jsoeterbroek/ktemata/docs/PAINT.md

# r5 paint schemes — deck and lid cover

**Strata is the chosen scheme.** It is the design to build; Meridian and Bearing are kept as record
of the alternatives and because the generator still produces them.

Three airbrush designs for the two printed surfaces you actually look at: the **deck** (keyboard
side, seen when the case is open) and the **lid cover** (one flat front panel around the recessed
Touch Display 2, 5", seen when it is closed). Each scheme is one continuous design across
both parts, not two decorations that happen to share a palette.

```
python3 cad/tools/paint.py                          # all three sheets + contact sheet
python3 cad/tools/paint.py --scheme 2 --stencils    # Strata + its cut files (also the default)
python3 cad/tools/paint.py --scheme 1               # Meridian colour sheet
python3 cad/tools/paint.py --stickers                # the two type blocks as sticker PDFs
python3 cad/tools/paint.py --no-png                 # SVGs only
```

Output lands in `docs/paint/`:

| File | What it is |
|---|---|
| `ktemata_paint_1_meridian.svg` / `.png` | **MERIDIAN** — a chart graticule ruled from the hinge |
| `ktemata_paint_2_strata.svg` / `.png` | **STRATA** — five bands up both rails, straight past the seam |
| `ktemata_paint_3_bearing.svg` / `.png` | **BEARING** — a slate border and one amber trace through the seam |
| `ktemata_paint_all.png` | the three sheets side by side, for choosing |
| `ktemata_stencil_{deck,cover}_{deep_amber,slate,amber,ash,hairline,ink}.svg` | **Strata cut files**, one per colour pass, `--stencils` |
| `ktemata_sticker_deck_wordmark_91x22.4mm_bleed.pdf` | **the deck wordmark sticker**, artwork only, `--stickers` |
| `ktemata_sticker_cover_motto_<W>x<H>mm_bleed.pdf` | **the lid motto sticker**, artwork only, `--stickers`; filename records its fitted trim size |

The SVGs are **1:1 in millimetres** and are drawn from the model, so they print as masking
templates: 400 gsm card or vinyl, cut to the panels, laid on the part. There is a 50 mm scale bar
on each sheet to check the printer did not rescale.

## The rule the three schemes share

The case opens flat into one face: the cover's 233.5 × 178.1 panel, and the deck's 243.3 × 186.8
plate, which is larger because it fills the host's cavity at its own height (see R5.md, "Your
host's actual interior"). Both are measured **from the hinge** (`y = 0`), exactly as `common.scad`
does, and they share **one x axis**. So a mark at `x = 214` is 19.5 mm from the right edge on the
cover *and* on the deck, and a mark at `y = 40` is 40 mm from the seam on whichever half you are
looking at. The deck's plate starts 4.4 mm before the seam and ends 4.4 mm past the cassette's
latch edge; that overhang is painted as part of the deck face.

Everything continuous in these designs is keyed to that datum:

- **MERIDIAN** lays its graticule out from the hinge at `L/10 = 17.81 mm` pitch, so line *n* is
  the same distance from the seam on either half.
- **STRATA** keys its bands to **x**, not y: each rail runs dead straight from the cover into the
  deck, and the U closes across the hinge.
- **BEARING** runs one 3 mm trace on `x = 215.5` down both parts, meeting in a gateway square
  straddling the seam.

## What the hardware allows — measured, not guessed

These are the constraints the artwork obeys, and `cad/tools/paint_probe.scad` feeds them to the
generator straight from `common.scad`. Change a part and the sheets follow; the assertions fail
rather than drawing a line through a fan.

- **The cover has one flat front at `z = 18.92 mm`.** Its rear mounting skin is **4.00 mm** thick
  (`z = 0..4.00`), and the display recess is **14.92 mm** deep (`z = 4.00..18.92`). The display
  glass and the entire broad cover front are coplanar; there is no raised bezel. The **145.4 ×
  93.46 mm display opening** (`R5_PANEL` + 1.0 mm clearance per side) is centred at
  `x 44.05..189.45`, `y 42.32..135.78`. Meridian's **7 mm slate border** around that opening is
  flat paint and a layout datum, not a keep-out. Marks may cross it; only the display opening,
  cable notch and reserved type interrupt them. The default layout leaves **37.05 mm
  outside the painted border in x** and a **35.32 mm latch band** below it, all on that same face.
  Nothing else on the cover breaks the painted face: the 7" build's FFC fold pocket is blind and
  lives in `cad/r5_lid_cover_waveshare_7in.scad`, and the 5" cover has no pocket at all.
- **The deck's free fields** are the **40.95 mm side rails**, the **35.6 mm strip** between the OLED
  window (ends `y 66.9`) and the keyboard pocket (starts `y 102.5`), and the **16 mm** between the
  keyboard pocket (ends `y 162.1`) and the latch edge. The right rail carries the power button
  (`213.0, 160.1`) and the charge socket (`216.0, 90.0`).
- **BEARING's retained trace uses the right-side lane at x 216.5 .. 223.0**. The **charge socket**
  (Ø14 envelope at 216.0, 90.0) interrupts that trace; if the alternative layout were revived it
  would need to jog around the socket, x 209..223. Removing the FB2 opening also leaves the left
  rail available for a future alternative layout.

  The power button is why the deck now has a hole where the 5" layout had clean rail: it moved
  off the lid when the panel grew to 7", and the rail at x 213 is the only place on the deck that
  is both clear of the keyboard pocket and clear of every board underneath. Its Ø19 nut needs
  9.2 mm of clearance to the keyboard skirt, which is exactly what the rail gives.
- **The lettering blocks are part of the mask.** MERIDIAN's graticule stops at the wordmark and
  the motto rather than running under them — the blocks are declared in `Model.type_boxes`,
  derived from the sticker trim, so no scheme can paint through them by accident and the
  graticule never ends as a sliver under the vinyl's edge.

## Paint order and finish

All three use the same process; only the masks change.

1. Scuff 400, clean, adhesion promoter for PETG, then **graphite base** (`#151b21`, the site's
   `--bg`) over the whole face.
2. Lay the masks for the first colour, spray, let it flash off. Thin coats — airbrush paint builds
   up in an aperture and reads as a burr.
3. Repeat per colour. The order on each sheet is the order to spray; darkest to lightest, so a
   light slip can be covered and a dark one cannot.
4. **Matte 2K clear** over everything.
5. Lettering last: MERIDIAN's two type blocks are **printed stickers** laid on the cleared plate
   (see below); STRATA and BEARING keep the stencil pass, un-cleared, so it keeps its edge.

### Palette

Taken from `site/style.css` so the case and the site are the same object:

| Name | Hex | Role | Pantone (Solid Coated) | Vallejo Model Air |
|---|---|---|---|---|
| graphite | `#151b21` | `--bg` — base coat, all three | Black 6 C `#101820` ΔE 1.7 | 71.057 Black ΔE 7.1 |
| amber | `#c99a63` | `--accent` — the line work that crosses the seam | 7509 C `#d6a461` ΔE 3.9 | 71.348 USAF Tan ΔE 2.9 |
| deep amber | `#8a6234` | `--accent-soft` — the seam rule, shading | 7575 C `#835d32` ΔE 2.2 | 71.032 Golden Brown ΔE 4.0 |
| slate | `#26313a` | `--panel`, lifted one step so it reads next to graphite at 300 mm | 7546 C `#253746` ΔE 3.5 | 3 : 1 71.057 Black + 71.087 Steel Blue ΔE 2.4 |
| ash | `#7c8993` | secondary line work | 430 C `#7c878e` ΔE 1.6 | 71.307 BS Medium Sea Grey ΔE 3.5 |
| light grey | `--muted` `#a9b2bb` | short graticule ticks, chart dots | 429 C `#a2aaad` ΔE 3.8 | 71.345 Russian AF Grey N.8 ΔE 4.4 |
| light amber | `#e2bd8d` | long ticks, the deck wordmark | 7508 C `#e1b87f` ΔE 2.4 | 71.074 Radome Tan ΔE 3.6 |
| ivory | `--fg` `#f2ebe0` | the motto | 7527 C `#d6d2c4` ΔE 6.3 | 71.279 Insignia White ΔE 3.9 |

Every sheet's `PALETTE` strip carries the five colours that scheme actually uses.

**How to read the two mixed columns.** ΔE is CIEDE2000 between the site hex and the matched
swatch, computed in CIELAB from the sRGB values; **below ~2 is indistinguishable side by side,
below ~5 reads the same at arm's length in daylight**, and everything in the table is under 5
except graphite and ivory. Those two are at the ends of the range where neither system has a
chip: nothing in Model Air is as dark as `#151b21` (71.057 is a half-step lighter, which the matte
clear mostly hides), and every Pantone chip near `#f2ebe0` is yellower — 7527 C is the closest
neutral and Pantone has no true off-white. Slate needs the two-pot mix because no single matte
Model Air matches it; 71.300 Glossy Sea Blue is closer but gloss, which is wrong under the 2K
clear on the painted border.

The Pantone column is for **checking, not spraying** — Pantone sells no paint. Use the chip at the
hobby shop to judge a tint under daylight, or to order the same tone from a paint mixer. The
Vallejo column is the **Model Air** number (the airbrush range, 71.xxx) because every pass here is
sprayed; Model Color (70.xxx) has hand-brush equivalents that are close but not identical, and
Model Color is brush-ready, so it will not go through a 0.2 mm nozzle without thinning and has no
place in these masks. Vallejo publishes no official RGB values — the hexes behind the ΔE numbers
come from community colour databases, so treat ΔE as a comparison between two approximations of
each colour, not as a measurement of the bottle in your hand.

## Cutting the masks

`--stencils` writes the six selected Strata cut files for each part, derived from the same mark
data as the colour sheet:

| Filename suffix | Pass | Cut |
|---|---|---|
| `deep_amber` | deep amber | 8 mm outer rails and the 2.6 mm latch band at `y 2.6` |
| `slate` | slate | 5 mm rail bands |
| `amber` | amber | 12 mm rail bands |
| `ash` | ash | 3 mm rail bands |
| `hairline` | light amber | 0.6 mm rail hairlines at `x 8` and `x W-8` |
| `ink` | graphite shadow | 0.6 mm latch shadow at `y 5.2` |

The innermost 4 mm rail band is the existing graphite base and needs no mask. Files are named
`ktemata_stencil_{deck,cover}_<pass>.svg`. The same masks are also printable as rigid 1.2 mm panels
(`stl/stencil/stencil_*.stl`) — see **Printed masks** below. Sheets and STLs come from `strata_marks()`,
so they cannot disagree.

Black is the sheet you lay on the part; white is what the blade removes. The full-length rail cuts
and the full-width latch cut can separate a mask into strips. Kiss-cut the vinyl, leave the backing
on, and use transfer tape to lift every island onto the part in register. The **0.6 mm hairline and
latch-shadow passes are at the limit for a hand-cut blade**; a vinyl cutter or 0.6 mm pinstripe tape
is preferable. Registration crosses in the margins align the passes; the part outline is the datum.

The six generated masks cover the rectangular colour geometry only. The wordmark and motto remain
a separate hand-cut type step from the colour sheet; they are not included in these files.

## Printed masks

```bash
python3 cad/tools/stencil_stl.py                  # twelve Strata masks, 1.2 mm thick
python3 cad/tools/stencil_stl.py --part cover      # six cover masks
python3 cad/tools/stencil_stl.py --pass amber      # one pass on both parts
python3 cad/tools/stencil_stl.py --thickness 2.0   # stiffer
```

Writes `stl/stencil/stencil_{deck,cover}_{deep_amber,slate,amber,ash,hairline,ink}.stl`: the part outline
with that pass's slots cut straight through and no handling margin — 243.3 × 186.8 mm for the deck,
233.5 × 178.1 mm for the cover. The deck fits a 256 mm bed. Full-length cuts make some masks
multi-piece; arrange those pieces against the part outline, or use the registered SVG sheet with
transfer tape when a single handling assembly is preferable.

**Every cover mask lies on the same flat front at `z = 18.92 mm`.** The display recess extends
14.92 mm down to the 4.00 mm rear skin, and the glass is flush with the surrounding front. There
is no raised bezel step to bridge. The display opening and cable notch pass through every mask;
Strata has no separate bezel-ring pass.

Two earlier corrections in the sheet output remain relevant:

- **The cover's apertures were not mirrored with its marks.** The cover is drawn mirrored in y on
  the open-flat sheet, so that its hinge edge meets the deck's at the seam, and the marks were
  flipped while the cut-outs were not — the DSI notch appeared at the latch end instead of the
  hinge. Apertures are now one `Aperture` shape rendered for both consumers.
- **The deck's apertures were drawn one height too low.** `Aperture.d()` applied the mirror
  unconditionally: right for the cover (drawn flipped) and wrong for the deck, so the keyboard hole
  landed at the latch edge and the Pi opening 20 mm inside the plate instead of on it. The STL
  masks, which cut at the aperture's own coordinates, were always right; the SVG sheets were not.
  The rectangle's two y edges are now both mapped and drawn from the smaller one.

## Reading a sheet

```
┌──────────────────────────────────────────────┐
│ LID COVER · front face       233.5 × 178.1   │  the cover, hinge edge at the BOTTOM
│  ┌────────────────────────────────────────┐  │
│  │  painted artwork, clipped by the mask  │  │
│  └────────────────────────────────────────┘  │
├──────────── HINGE (dashed) ───────────────────┤  the seam: paint crosses it
│ DECK · top face              243.3 × 186.8   │  the deck, hinge edge at the TOP
│  ┌────────────────────────────────────────┐  │
│  └────────────────────────────────────────┘  │
└──────────────────────────────────────────────┘
```

The cover is drawn **mirrored in y** so that its hinge edge meets the deck's at the dashed line —
that is the open-flat view, looking at both faces from the front. Consequently the cover's panel
(the display) appears "above" the hinge line rather than below it. The x axis is *not* mirrored.

Grey text and grey outlines name printed features — fan, screws, keyboard well, OLED window,
panel, button, cable relief. They are annotations, not paint. Every painted element is clipped by
the part's real apertures (`deck_holes_d`, `cover_holes_d`), so a line that reaches the Pi opening
or the power button **stops there** in the drawing exactly as it would under tape. Nothing in these
sheets is "touched up by hand" after masking.

## Strata: what to spray

The chosen scheme has six generated colour masks on each part:

1. Scuff 400, adhesion promoter, **graphite** (`#151b21`) over the whole face.
2. **Deep amber**: the 8 mm outer rails and the 2.6 mm latch band at `y 2.6`.
3. **Slate**: the 5 mm rail bands immediately inboard of the deep amber.
4. **Amber**: the 12 mm rail bands.
5. **Ash**: the 3 mm rail bands; the innermost 4 mm remains the graphite base.
6. **Light amber**: the 0.6 mm hairlines at `x 8` and `x W-8`.
7. **Graphite shadow**: the 0.6 mm latch line at `y 5.2`.
8. Finish and lettering follow **Paint order and finish** above. The wordmark, motto and `r5`
   lettering are separate from the six rectangular colour masks; take their type from the sheet.

## Meridian (alternative): what to spray

The alternative scheme, in the order its sheet gives:

1. Scuff 400, adhesion promoter, **graphite** (`#151b21`) over the whole face.
2. **Ash** pass: the graticule at 17.81 mm pitch, 0.5 mm lines.
3. **Amber** pass: every fifth line at 0.9 mm, plus the two rules.
4. **Deep amber** pass: the 1.7 mm seam rule at `y 2.2` and the end stop at `y l-8`. On the deck the
   seam rule is **two pieces**, not one — the Pi opening cuts it at `x 150..203.4`. That is correct
   and deliberate: the cut file is the authority, and a line that crosses a hole is not a line.
5. **Slate** pass (cover only): the flat 7 mm painted border around the display opening.
6. Matte 2K clear over everything.
7. **Stickers last**: the deck wordmark and the lid motto, on the bare plate the mask reserved.
   See [Stickers instead of stencilled type](#stickers-instead-of-stencilled-type).

## Stickers instead of stencilled type

The two type blocks — `KTEMATA` / `OFFLINE LIBRARY` on the deck and `κτῆμα ἐς ἀεί` / the
translation on the cover — are the only place in Meridian where the lettering is not masked
paint. `--stickers` writes them as print-ready vinyl instead:

| File | Block | Trim (cut size) | Where it goes |
|---|---|---|---|
| `ktemata_sticker_deck_wordmark_91x22.4mm_bleed.pdf` | `KTEMATA` + `OFFLINE LIBRARY` | **91 × 22.4 mm** | deck, x 71.25..162.25, y 68.40..90.80 |
| `ktemata_sticker_cover_motto_<W>x<H>mm_bleed.pdf` | `κτῆμα ἐς ἀεί` + translation | **W × H, fitted from the model** | cover, centred in the latch band below the flat 7 mm painted border |

Upload the **PDF**. It is vector (PDF 1.7, not the 1.4 they reject), all lettering already
converted to outlines, RGB — they convert to their CMYK profile themselves — and it carries **no
cut line and no crop marks**, which is what their upload form requires. Each file has 1 mm of
bleed on all four sides beyond the trim: the deck artwork measures 93 × 24.4 mm, and the cover
artwork is its model-derived trim size plus 2 mm on each axis. Order a **contour-cut rectangle at
the trim size above**, centred. Matte laminate matches the 2K clear finish. The trim size is also
in the file name and the SVG `<title>`, because the order form asks for it as a number and a file
name is harder to lose than a note.

Why the design survives as a sticker when it would not survive as a stencil:

- The tagline and the translation are 2.4–2.6 mm text. That is a 0.3 mm stroke through a hand-cut
  vinyl mask — below what a blade holds cleanly, and a slipped stencil cannot be repaired
  invisibly. Printed, it is just ink.
- The block is a **filled graphite rectangle**, not a transparent cut-out. A die-cut that follows
  the lettering is impossible at 0.3 mm, so the lettering needs a carrier. Printing that carrier
  in the scheme's own `#151b21` means the only visible change is a 2.5 mm graphite margin round
  the type — a small brand plate, not a white label. The 1 mm bleed is the same graphite, so a
  cut a fraction off-centre cannot expose white.
- `type_boxes` in the model is now **derived from the sticker trim** (`sticker_trim()`), so the
  graticule stops exactly at the vinyl's edge. Resize the sticker and the keep-out in the mask
  follows; a grid line can never end up a sliver under the edge.

Lay them **after** the 2K clear, not before: the clear is the part's mechanical protection, and a
sticker under it would have to pass the same wet-coat test the paint does. Press down hard on a
clean, de-greased clear coat; a vinyl sticker on scuffed PETG without clear under it is the one
joint that will lift at the corner in a pocket.

Text metrics are measured from the same `DejaVu Sans` font that draws the sheets. The deck cap is
10.5 mm; the cover cap and trim are fitted to the latch band derived from the model. The sticker
and painted artwork therefore remain the same design, not a lookalike.

## Printing notes

- Paint before assembly with the visible face upward: the deck's top face and the cover's recessed
  front. The deck prints top-face-down and the cover prints lid/tape-face-down, so the cover's
  painted front is the **top of the print**, not its bed face. Scuff both; do not sand them flat.
- Mask the apertures from the back where you can; the deck's fan grille bars are flush with the
  top face and will pick up overspray through the slots.
- The key faces (K06 keys, the display glass) are not painted and must stay masked throughout.
