jsoeterbroek/ktemata/docs/paint/ktemata_paint_1_meridian.png

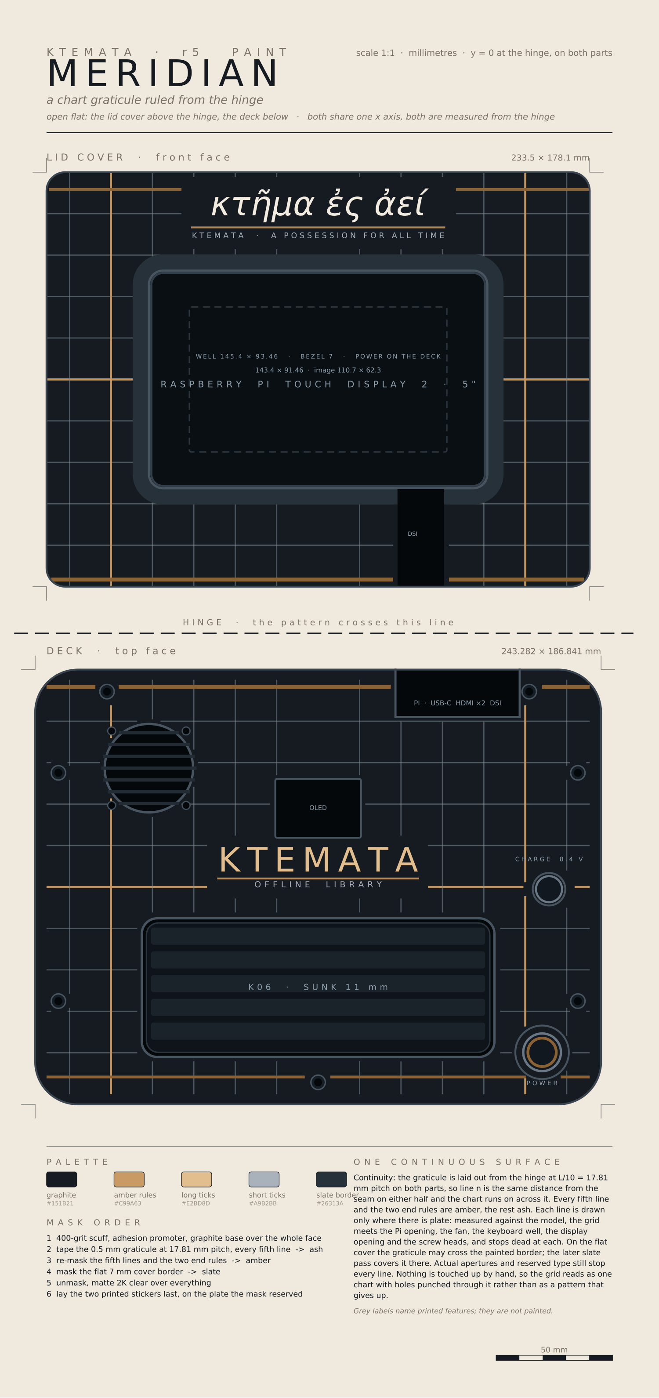
docs/paint/ktemata_paint_1_meridian.png
