jsoeterbroek/ktemata/docs/paint/ktemata_paint_2_strata.png

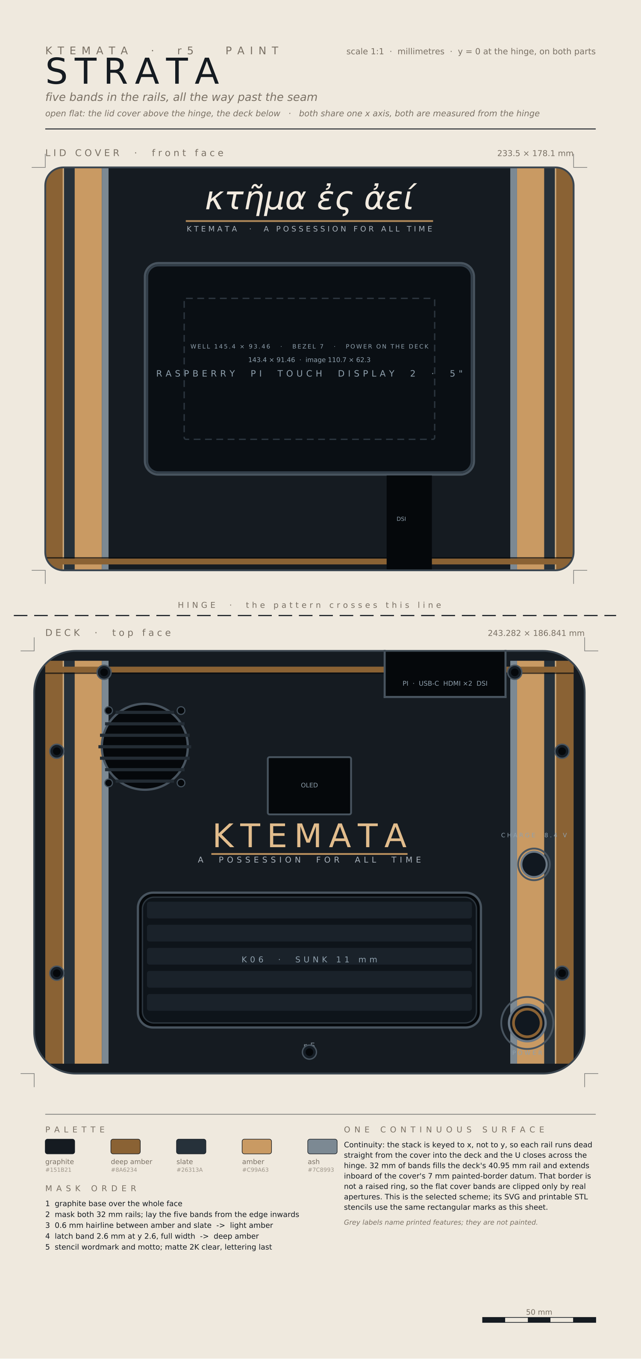
docs/paint/ktemata_paint_2_strata.png
