jsoeterbroek/ktemata/docs/paint/ktemata_paint_all.png

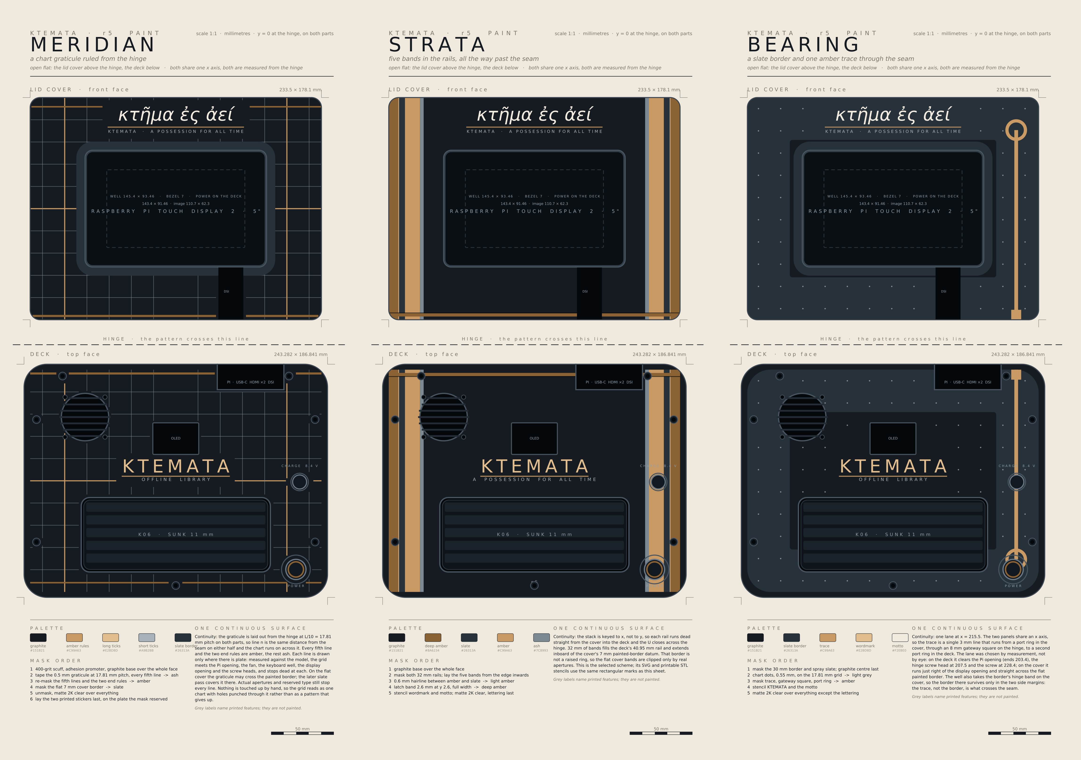
docs/paint/ktemata_paint_all.png
