jsoeterbroek/ktemata/docs/paint/ktemata_stencil_cover_amber.png

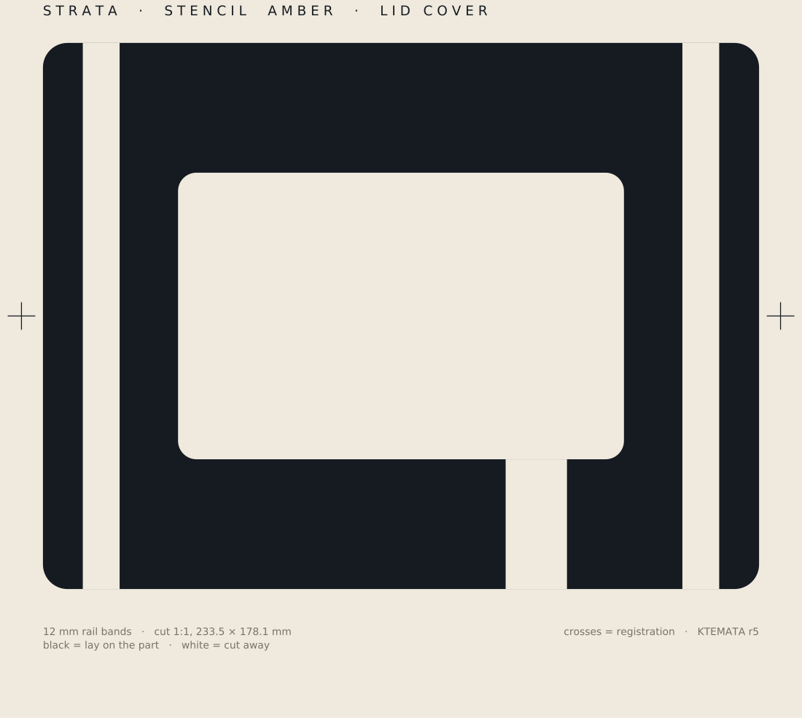
docs/paint/ktemata_stencil_cover_amber.png
