jsoeterbroek/ktemata/docs/paint/ktemata_stencil_cover_ash.png

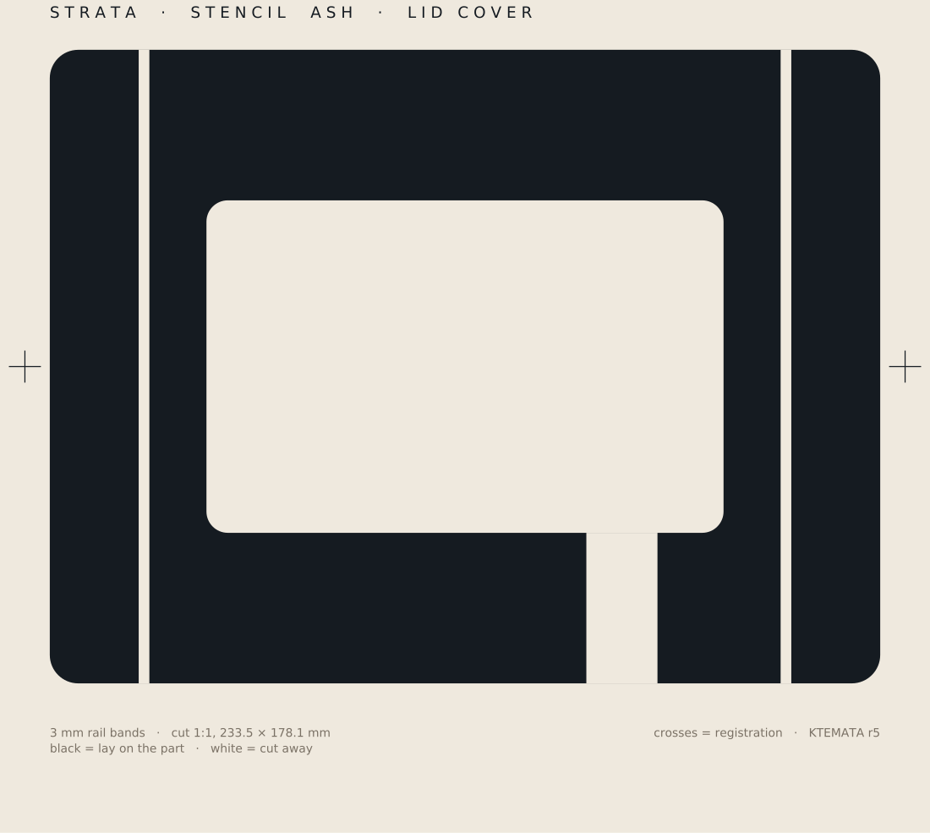
docs/paint/ktemata_stencil_cover_ash.png
