jsoeterbroek/ktemata/docs/paint/ktemata_stencil_cover_deep_amber.png

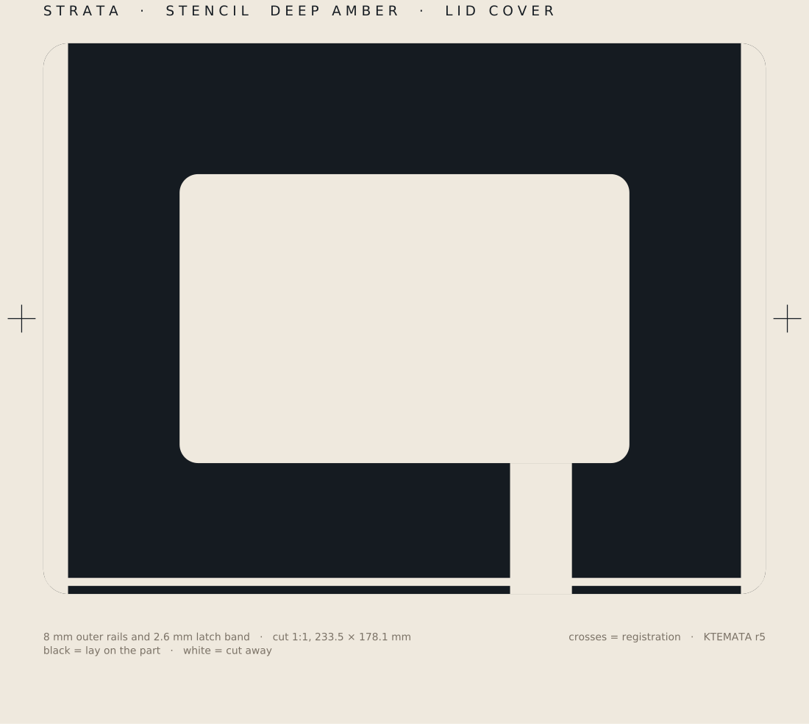
docs/paint/ktemata_stencil_cover_deep_amber.png
