jsoeterbroek/ktemata/docs/paint/ktemata_stencil_cover_ink.png

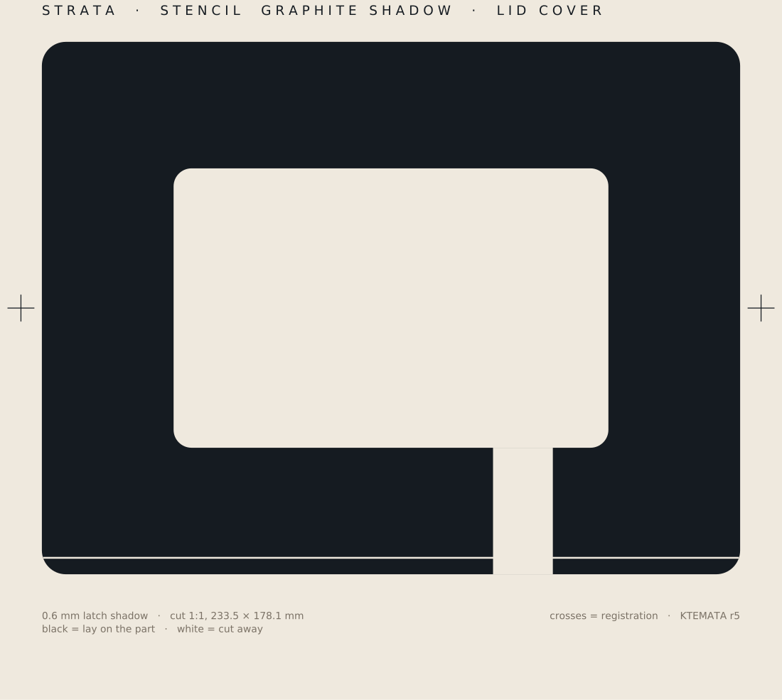
docs/paint/ktemata_stencil_cover_ink.png
