jsoeterbroek/ktemata/docs/paint/ktemata_stencil_cover_slate.png

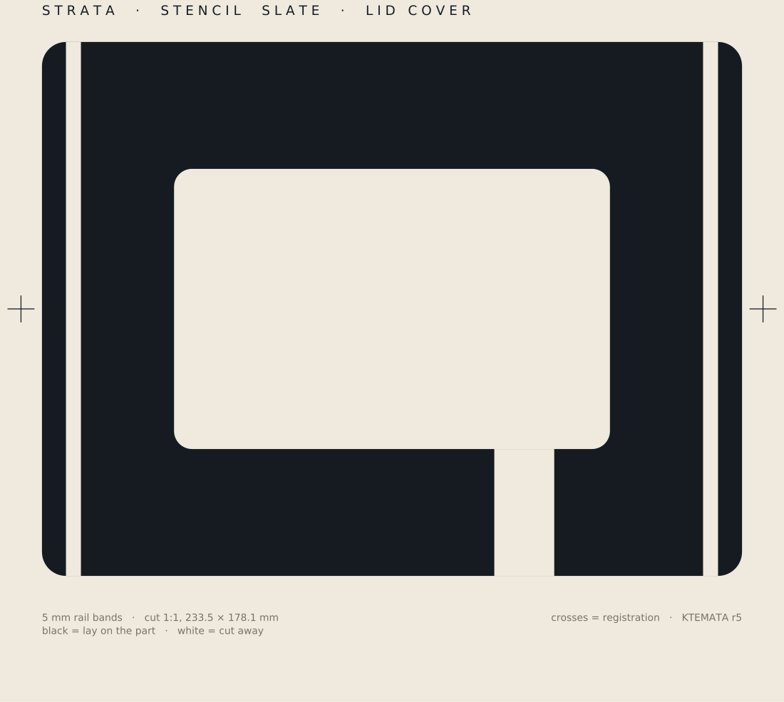
docs/paint/ktemata_stencil_cover_slate.png
