jsoeterbroek/ktemata/docs/paint/ktemata_stencil_deck_amber.png

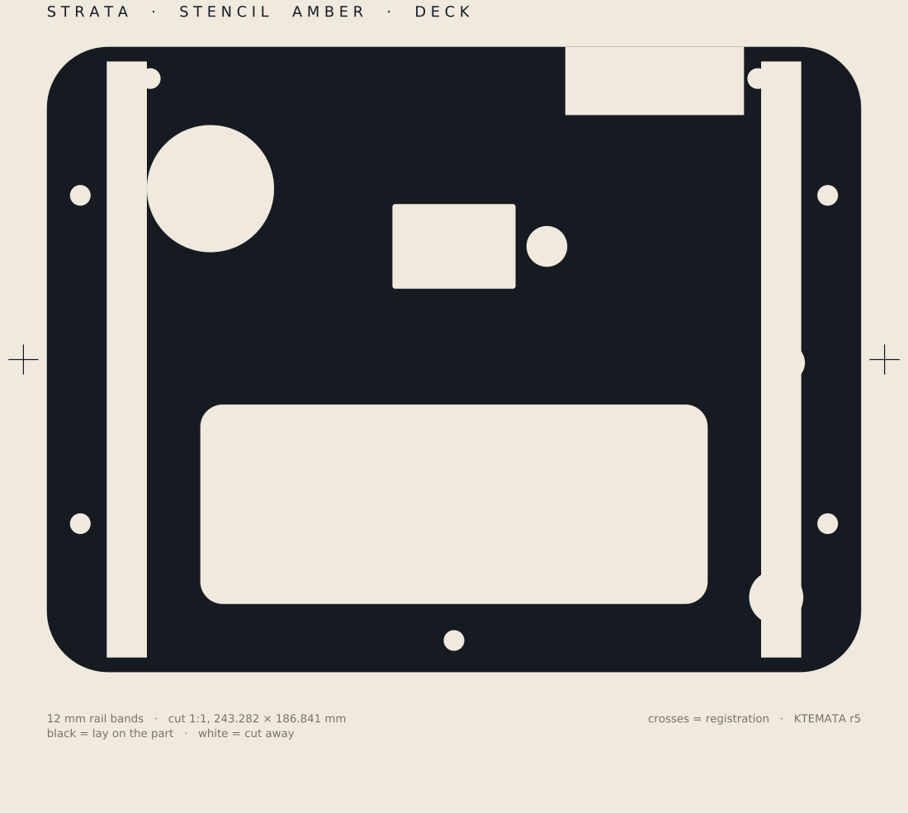
docs/paint/ktemata_stencil_deck_amber.png
