jsoeterbroek/ktemata/docs/paint/ktemata_stencil_deck_ash.png

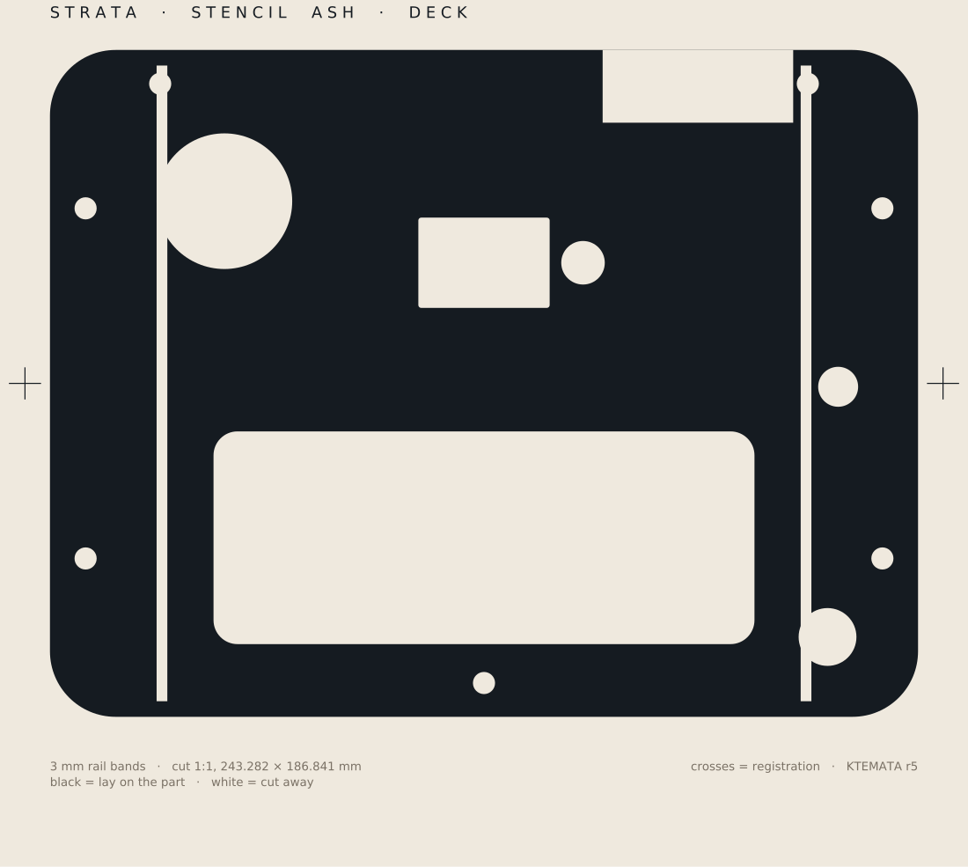
docs/paint/ktemata_stencil_deck_ash.png
