jsoeterbroek/ktemata/docs/paint/ktemata_stencil_deck_deep_amber.png

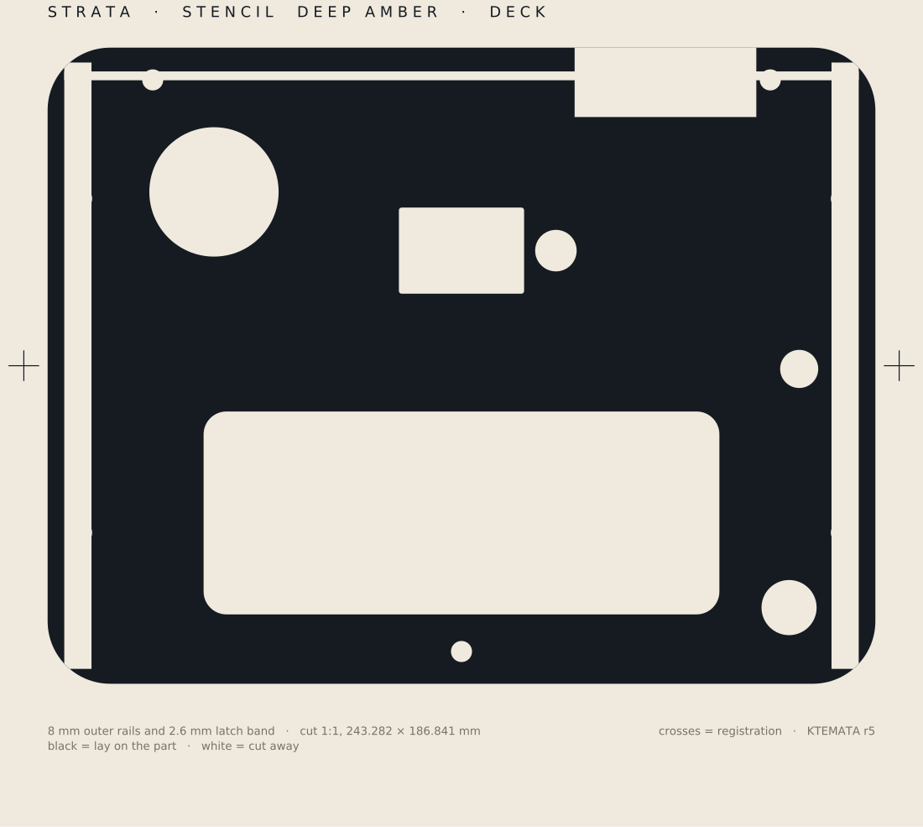
docs/paint/ktemata_stencil_deck_deep_amber.png
