jsoeterbroek/ktemata/docs/paint/ktemata_sticker_cover_motto_89.7x21.3mm_bleed.png

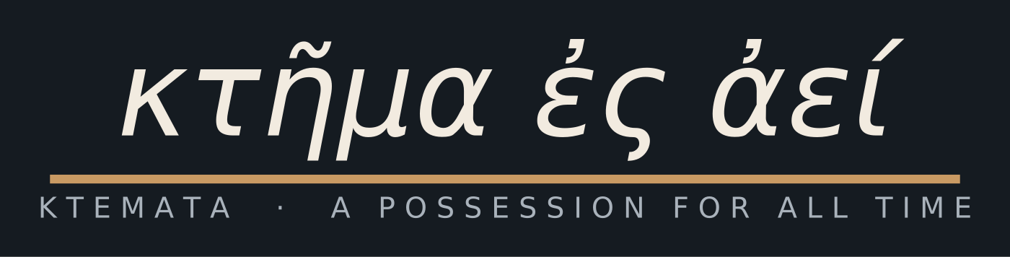
docs/paint/ktemata_sticker_cover_motto_89.7x21.3mm_bleed.png
