jsoeterbroek/ktemata/docs/paint/ktemata_sticker_deck_wordmark_91x22.4mm_bleed.png

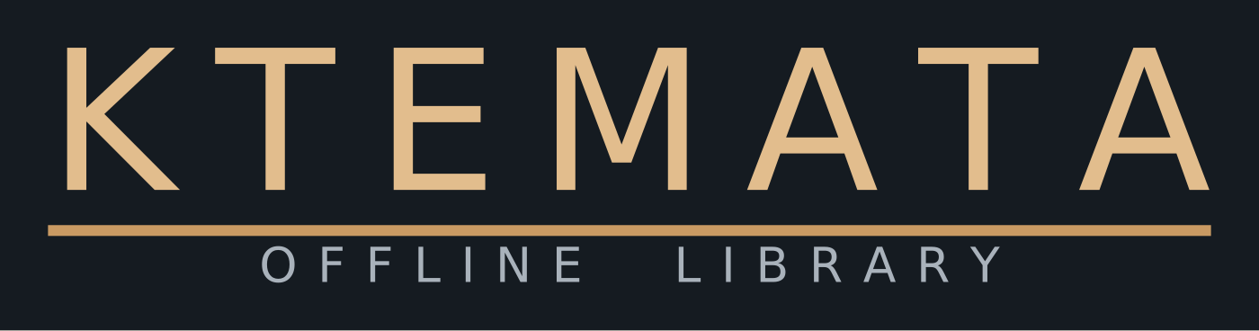
docs/paint/ktemata_sticker_deck_wordmark_91x22.4mm_bleed.png
