jsoeterbroek/ktemata/renders/asm_back.png

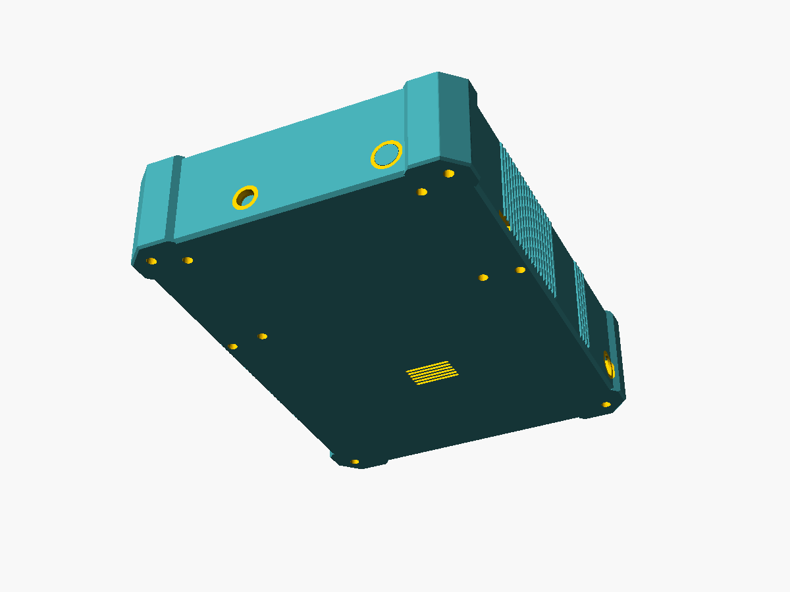
renders/asm_back.png
