jsoeterbroek/ktemata/renders/asm_corner.png

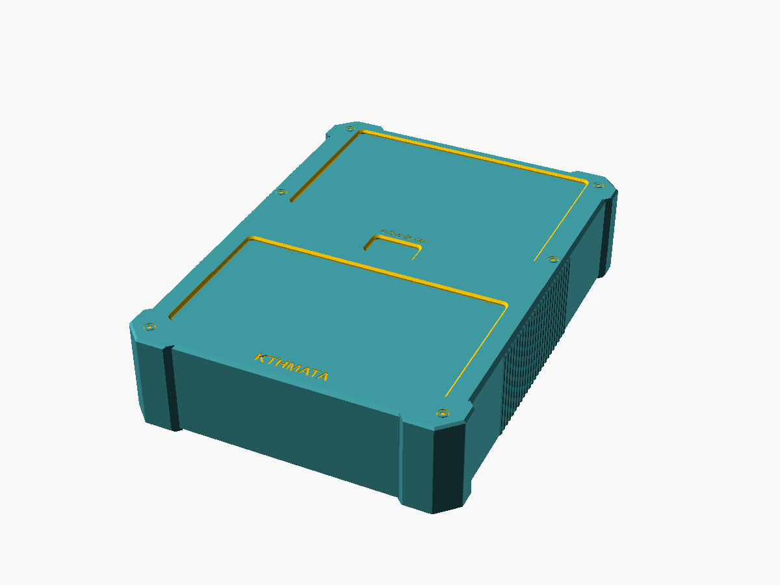
renders/asm_corner.png
