jsoeterbroek/ktemata/renders/asm_sec.png

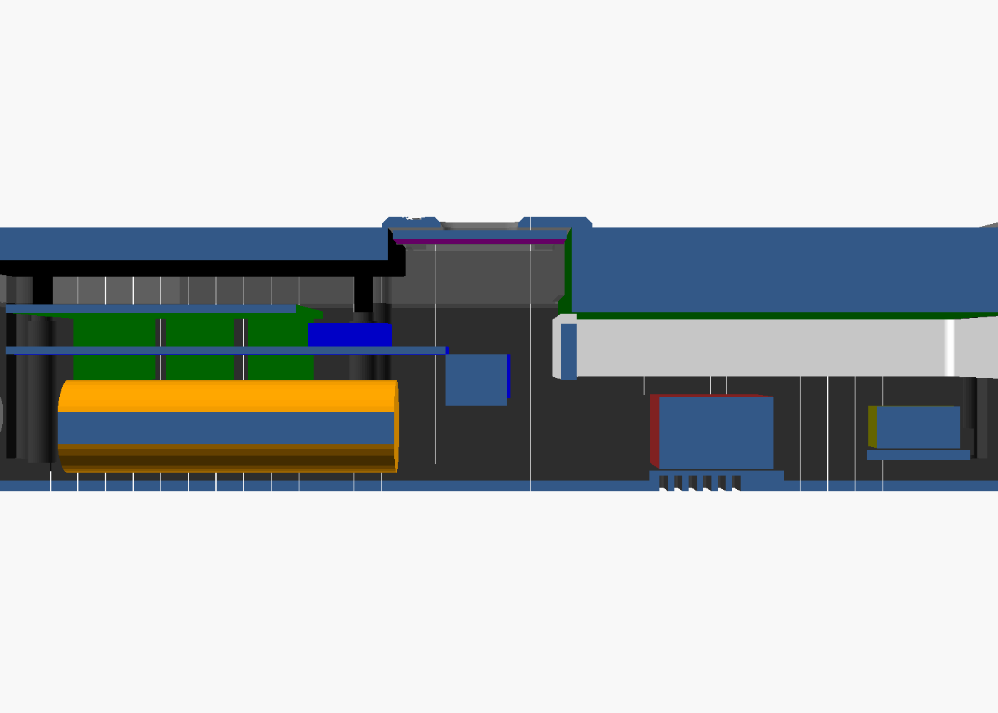
renders/asm_sec.png
