jsoeterbroek/ktemata/renders/bottom_iso.png

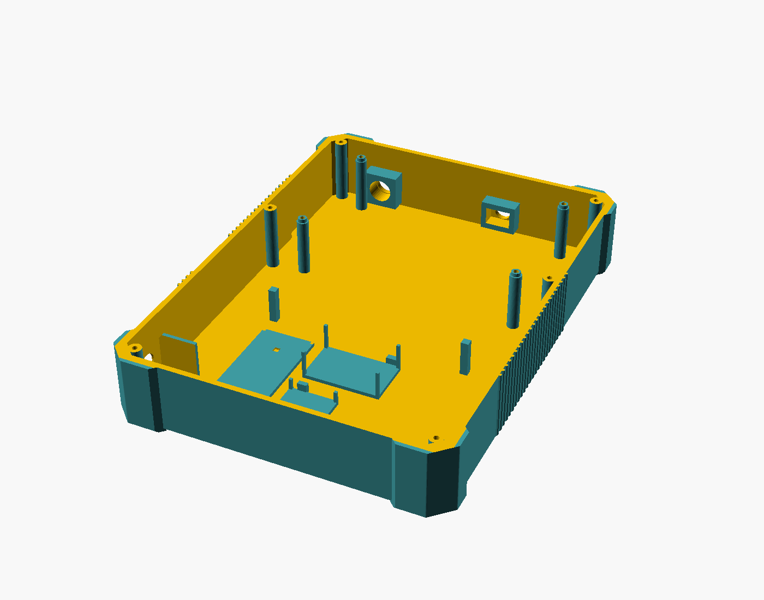
renders/bottom_iso.png
