jsoeterbroek/ktemata/renders/face_iso.png

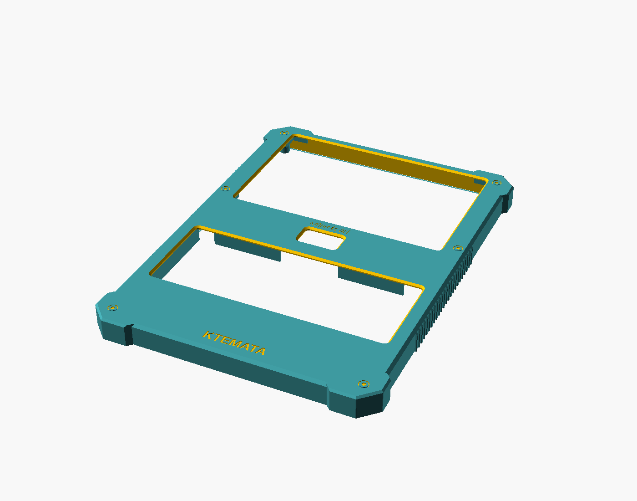
renders/face_iso.png
