jsoeterbroek/ktemata/renders/keyboard_support.png

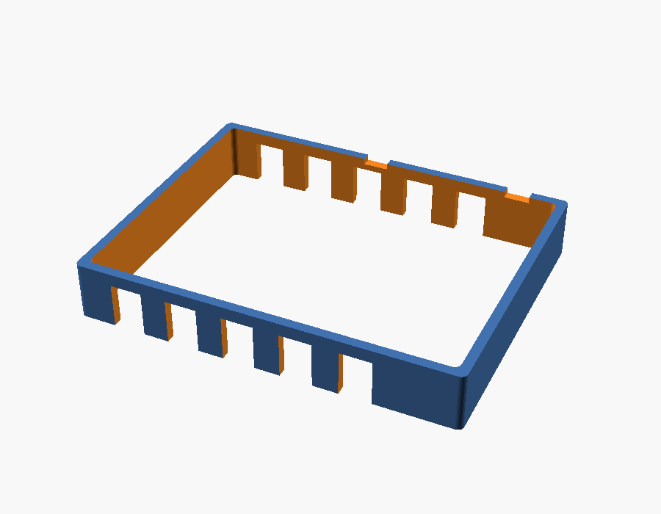
renders/keyboard_support.png
