jsoeterbroek/ktemata/renders/ktemata_charge_plug.png

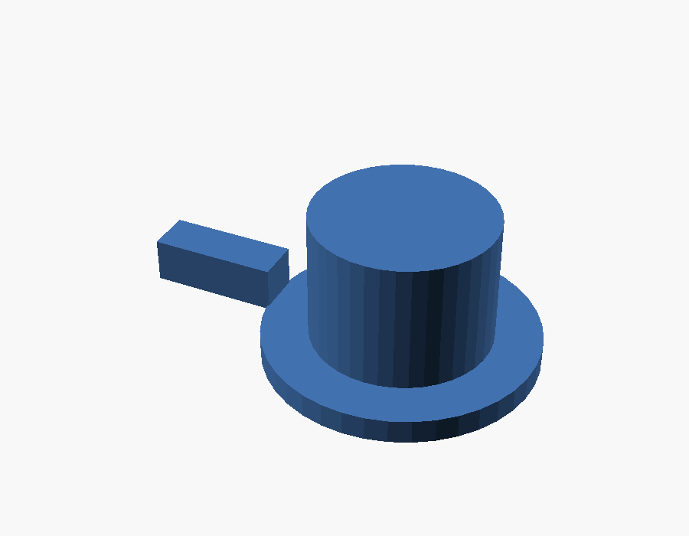
renders/ktemata_charge_plug.png
