jsoeterbroek/ktemata/renders/ktemata_corner_cap.png

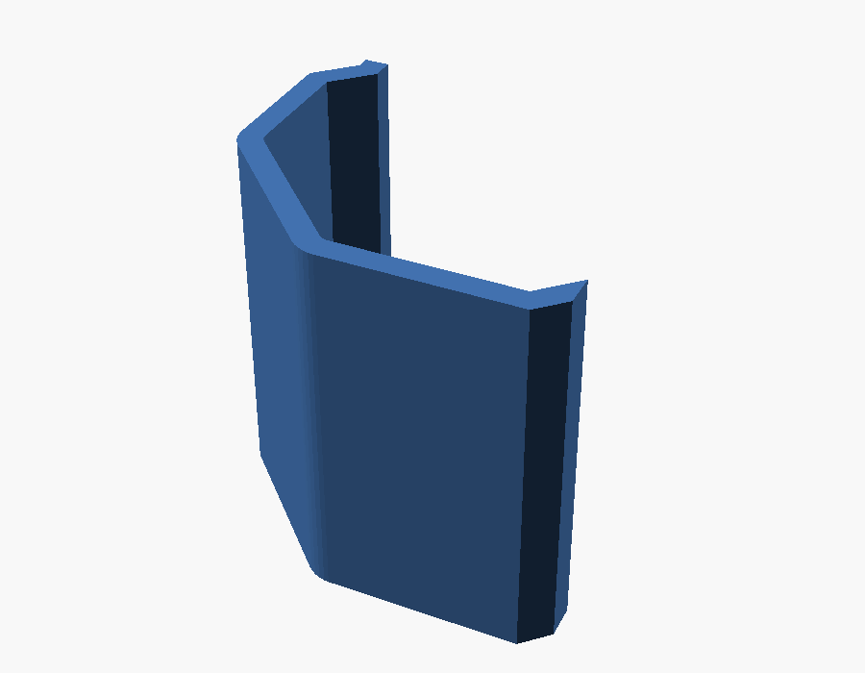
renders/ktemata_corner_cap.png
