jsoeterbroek/ktemata/renders/ktemata_corner_cup.png

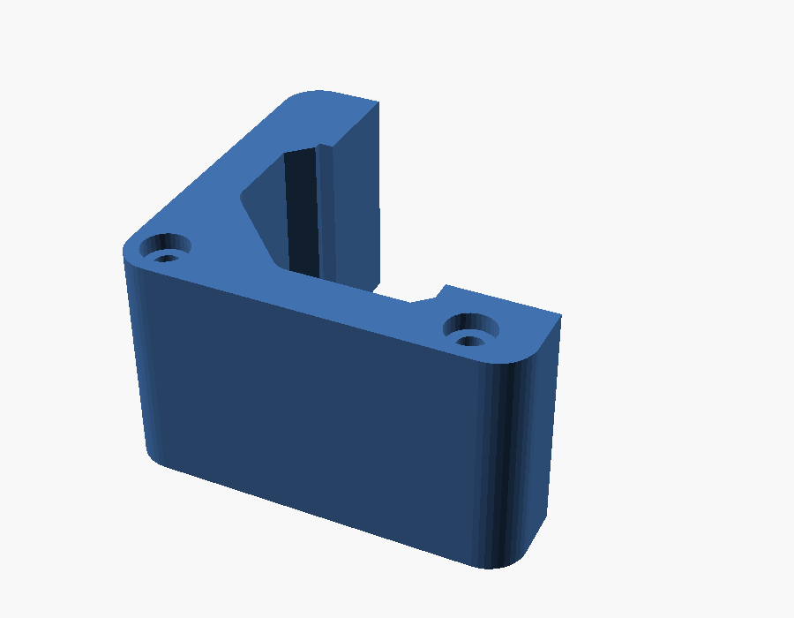
renders/ktemata_corner_cup.png
