jsoeterbroek/ktemata/renders/ktemata_corner_lid.png

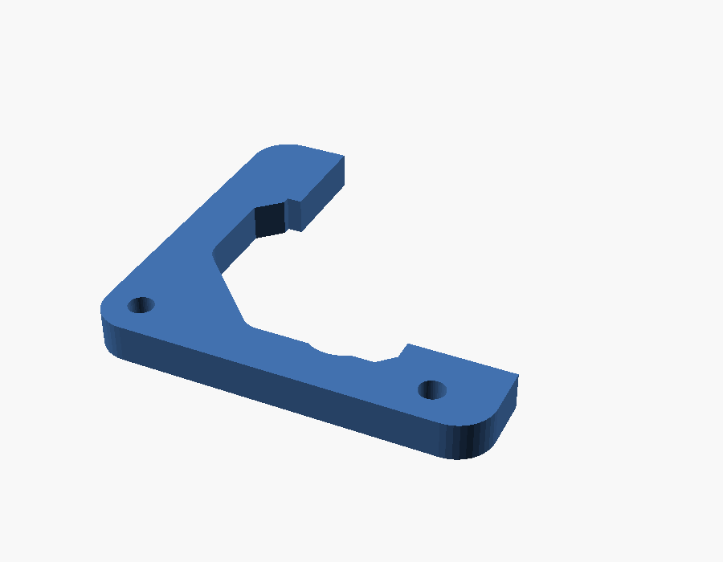
renders/ktemata_corner_lid.png
