jsoeterbroek/ktemata/renders/ktemata_power_button.png

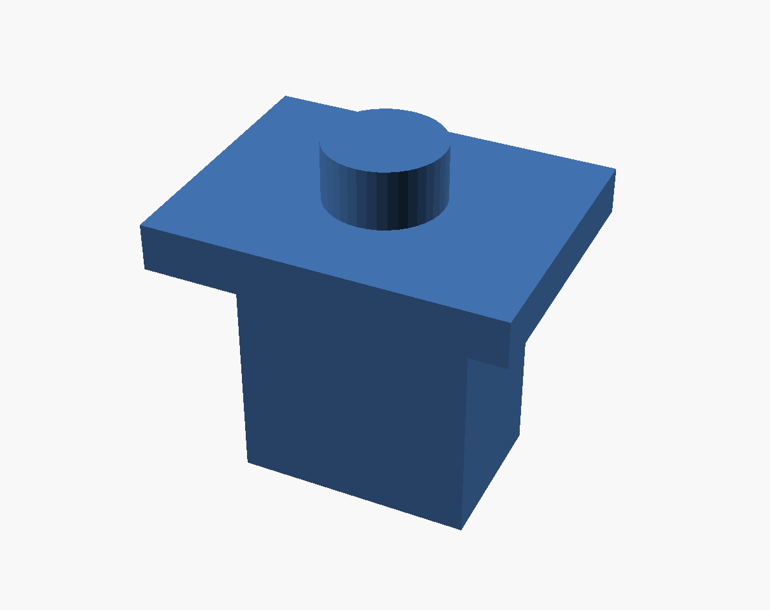
renders/ktemata_power_button.png
