jsoeterbroek/ktemata/renders/ktemata_pull_switch.png

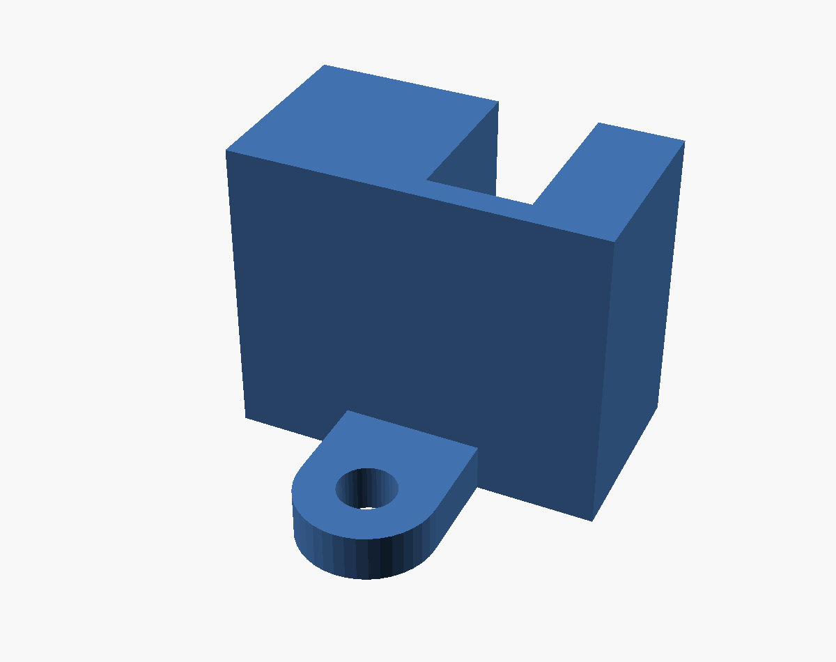
renders/ktemata_pull_switch.png
