jsoeterbroek/ktemata/renders/power_button.png

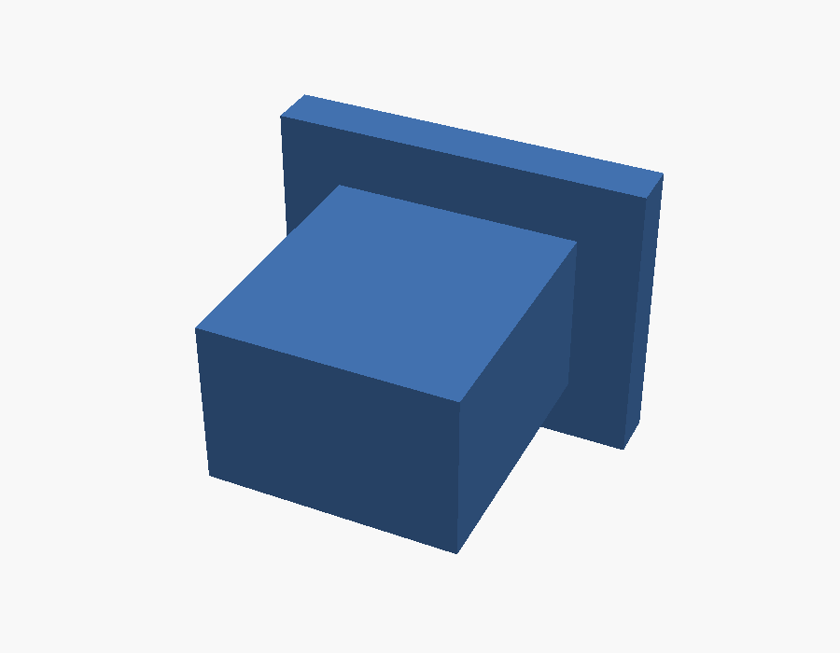
renders/power_button.png
