jsoeterbroek/ktemata/renders/pull_switch.png

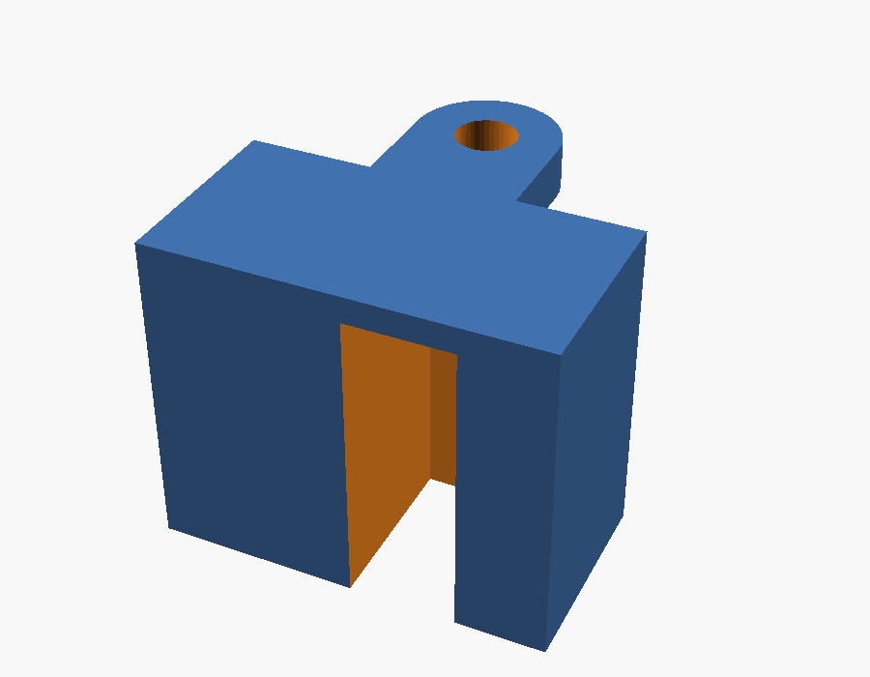
renders/pull_switch.png
