jsoeterbroek/ktemata/renders/r5/ktemata_r5_deck.png

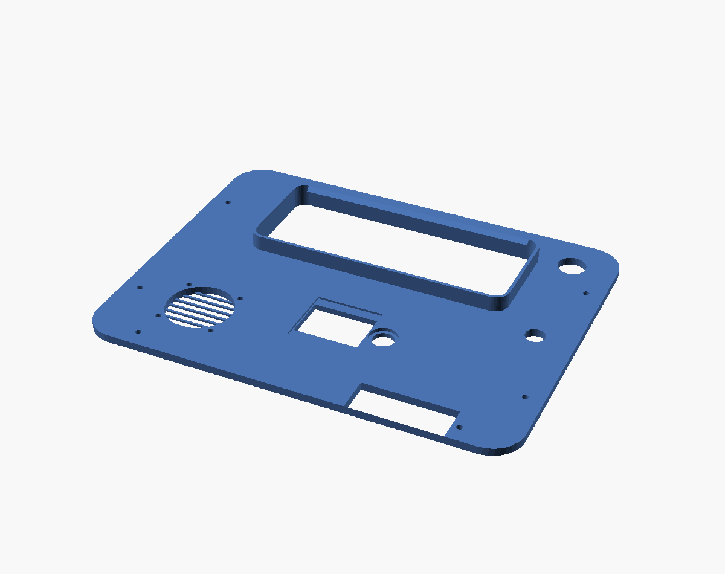
renders/r5/ktemata_r5_deck.png
