jsoeterbroek/ktemata/renders/r5/ktemata_r5_lid_cover.png

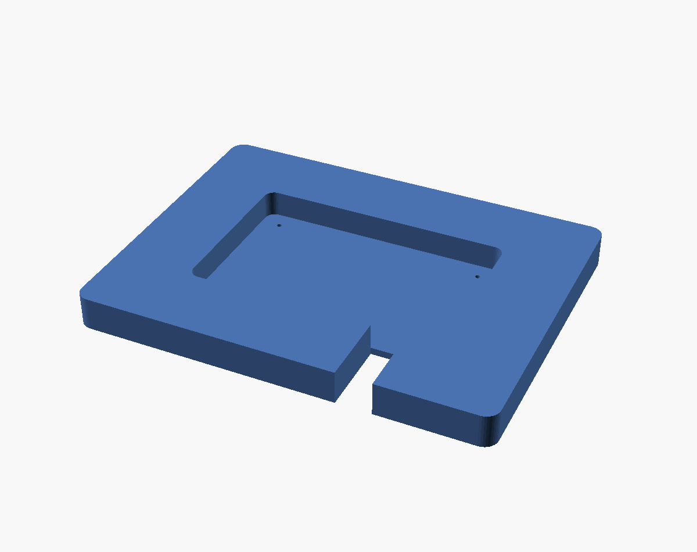
renders/r5/ktemata_r5_lid_cover.png
