jsoeterbroek/ktemata/renders/r5/ktemata_r5_lid_cover_waveshare_7in.png

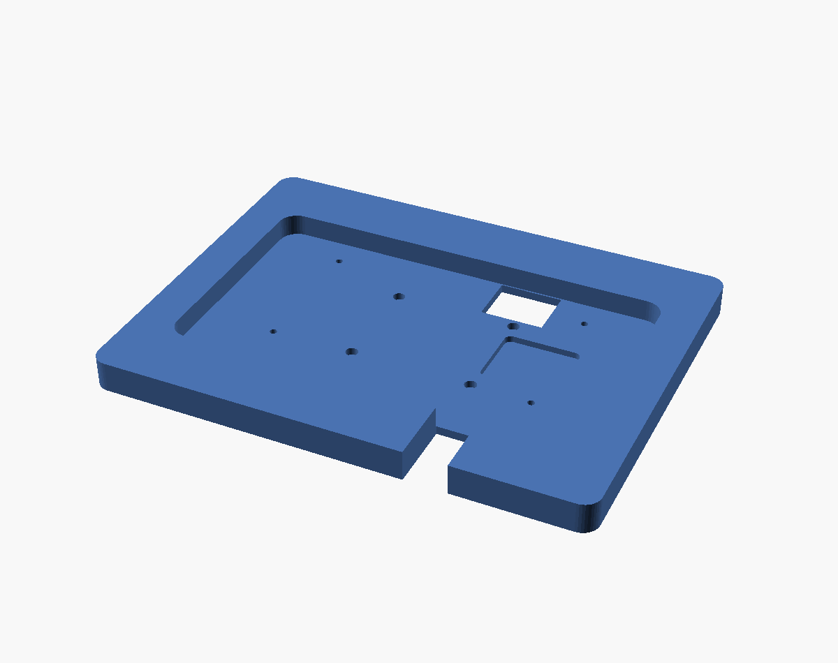
renders/r5/ktemata_r5_lid_cover_waveshare_7in.png
