jsoeterbroek/ktemata/renders/r5/ktemata_r5_lid_plate.png

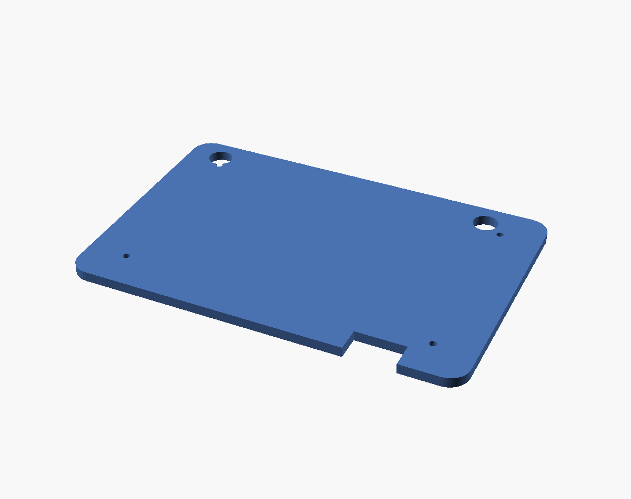
renders/r5/ktemata_r5_lid_plate.png
