jsoeterbroek/ktemata/renders/r5/ktemata_r5_tray.png

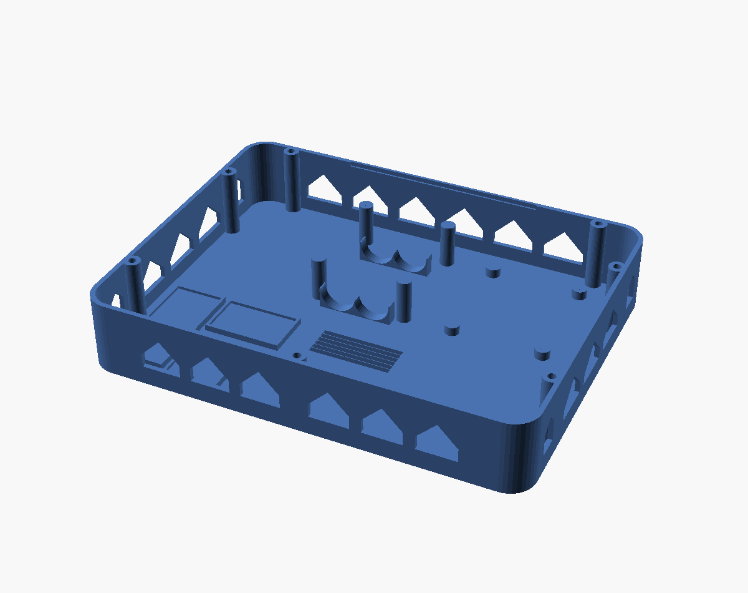
renders/r5/ktemata_r5_tray.png
