jsoeterbroek/ktemata/renders/r5/r5_cassette.png

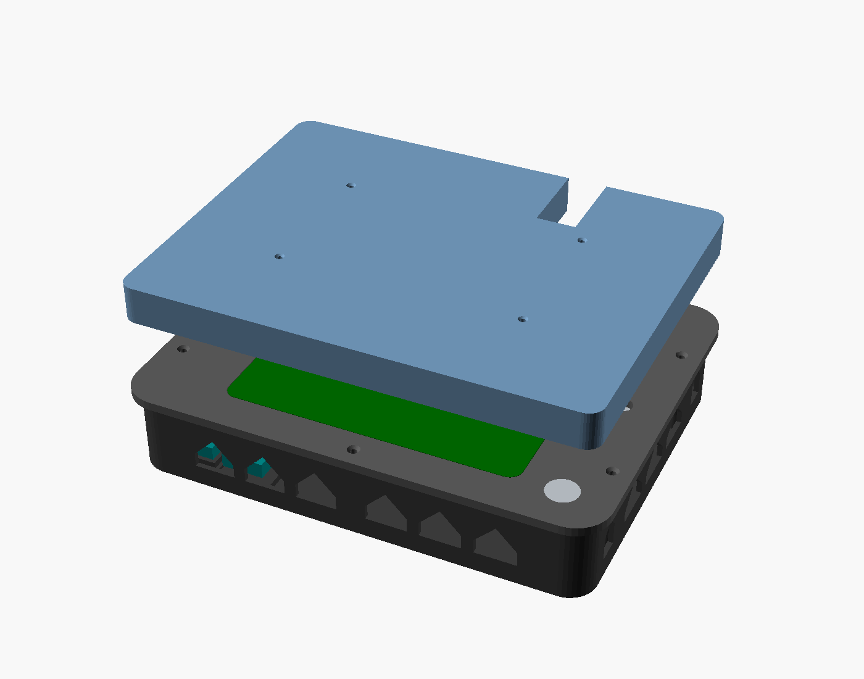
renders/r5/r5_cassette.png
