jsoeterbroek/ktemata/renders/r5/site_r5_exploded.png

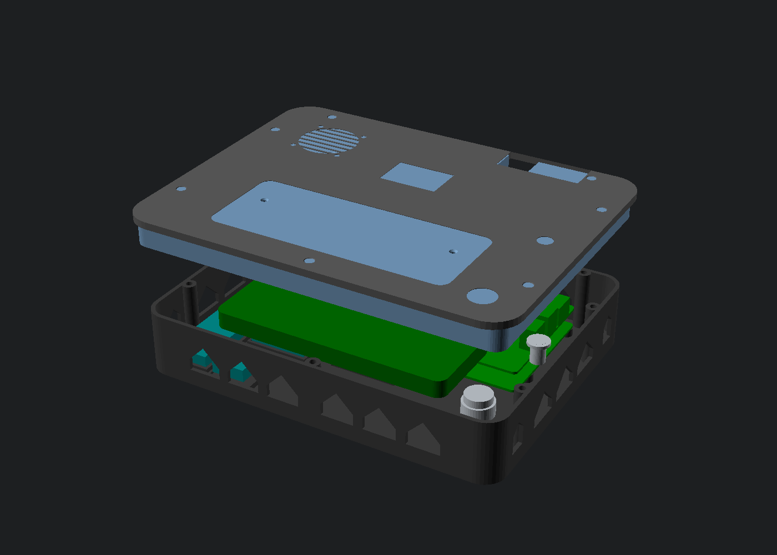
renders/r5/site_r5_exploded.png
