jsoeterbroek/ktemata/renders/r5/site_r5_showcase.png

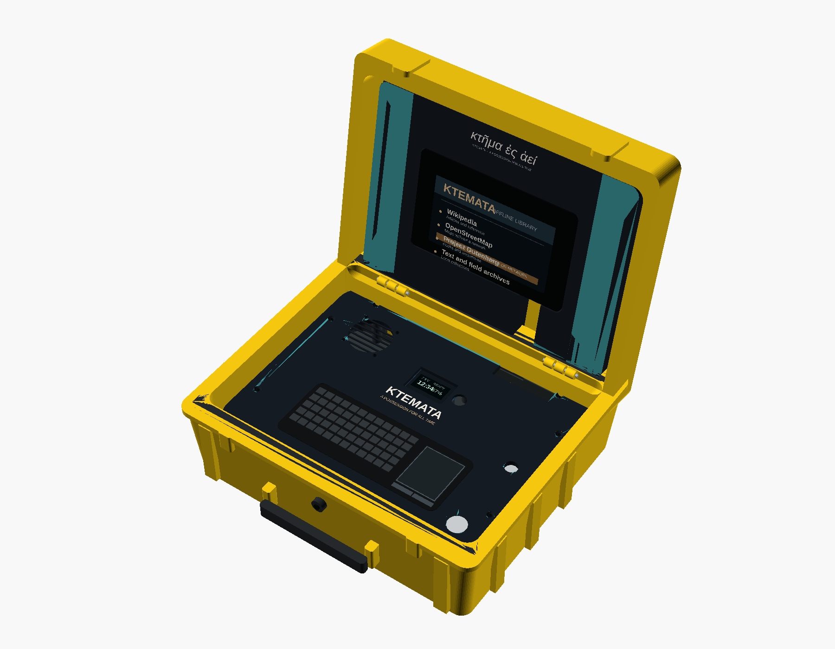
renders/r5/site_r5_showcase.png
