jsoeterbroek/ktemata/site/img/site_24_7.png

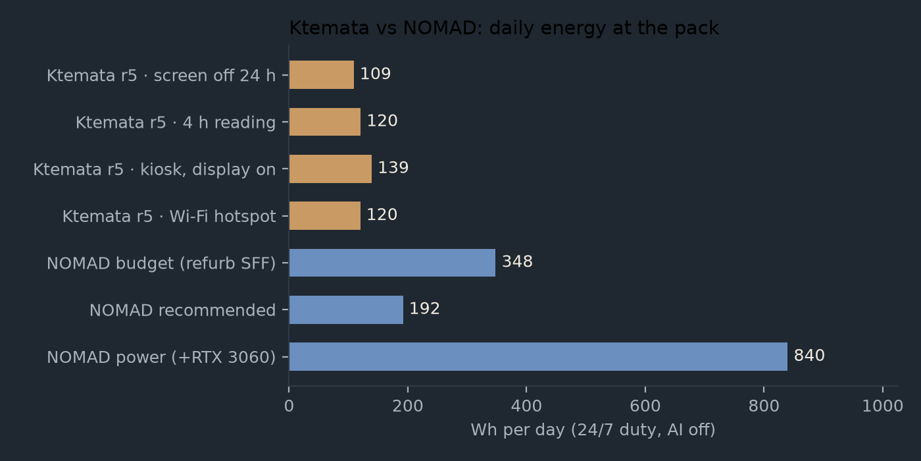
site/img/site_24_7.png
