jsoeterbroek/ktemata/site/img/site_autonomy.png

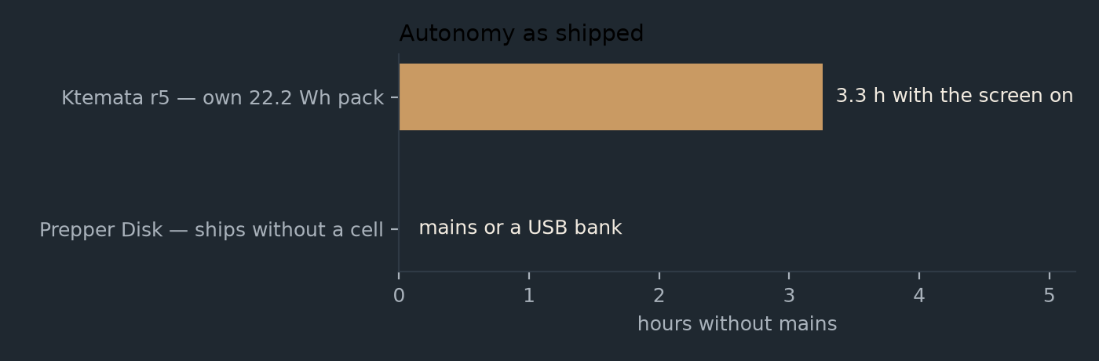
site/img/site_autonomy.png
