jsoeterbroek/ktemata/site/img/site_energy.png

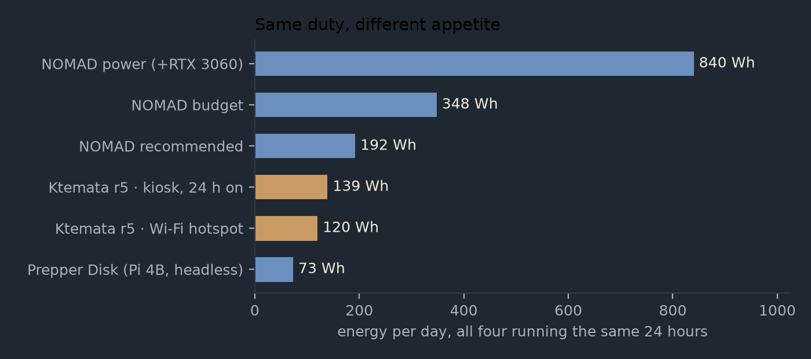
site/img/site_energy.png
