jsoeterbroek/ktemata/site/img/site_profile.png

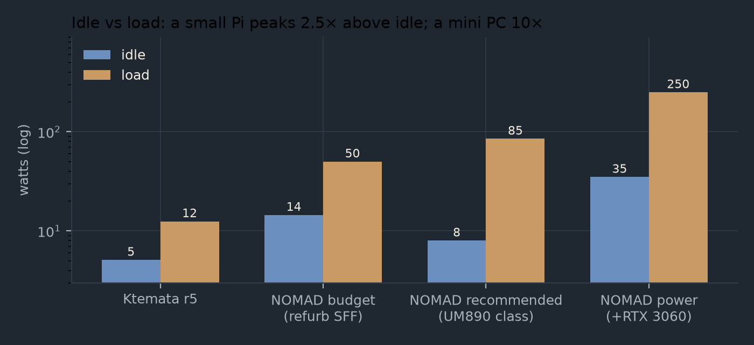
site/img/site_profile.png
