jsoeterbroek/ktemata/site/img/site_r5_showcase_realistic.png

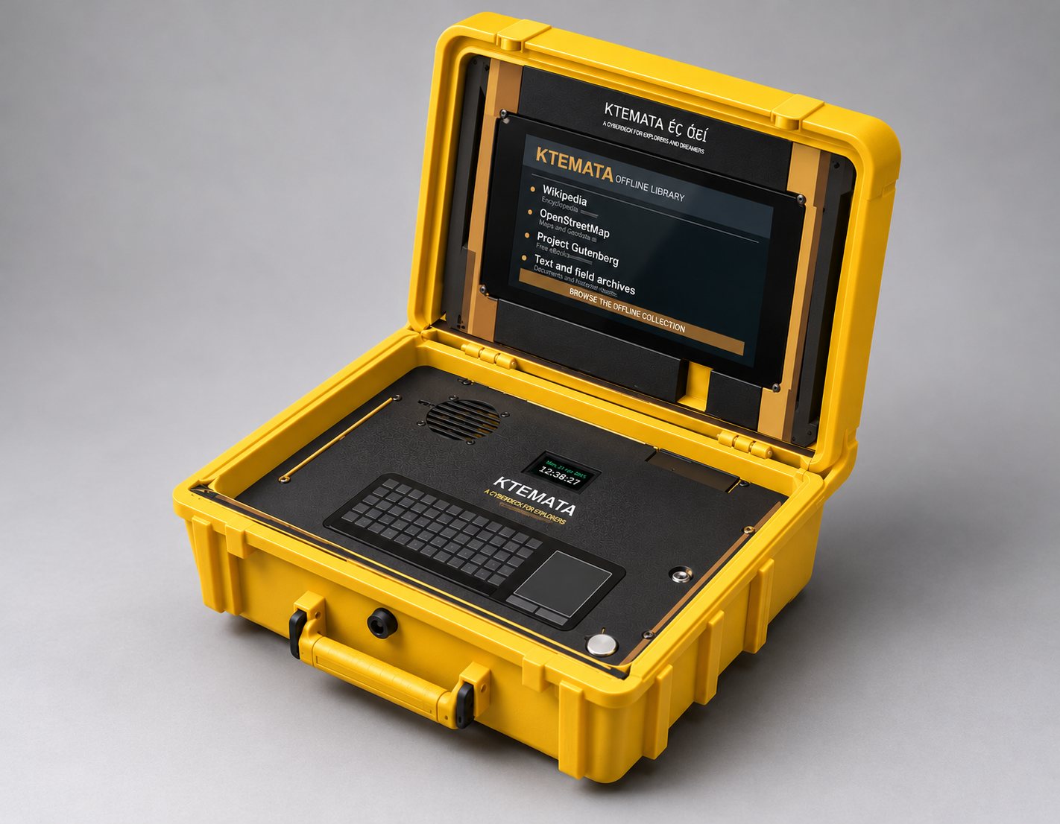
site/img/site_r5_showcase_realistic.png
