jsoeterbroek/ktemata/site/img/site_readers.png

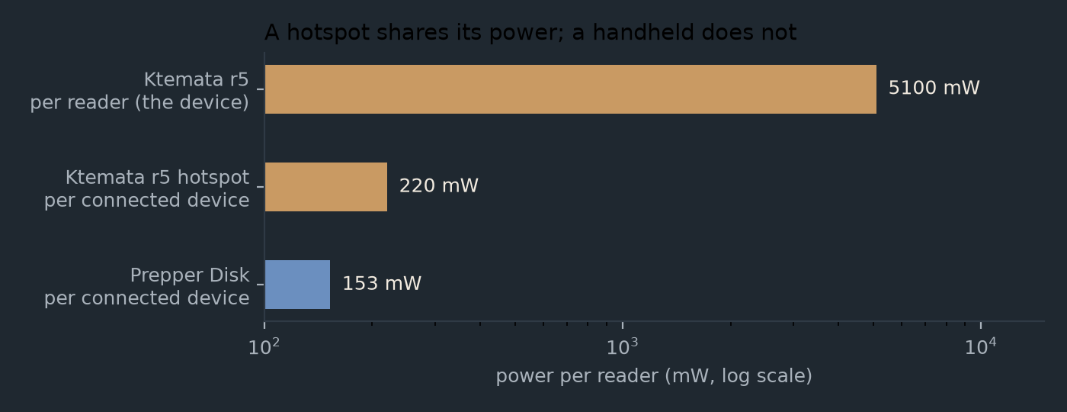
site/img/site_readers.png
