jsoeterbroek/ktemata/work/scripts/ktemata-wallpaper.png

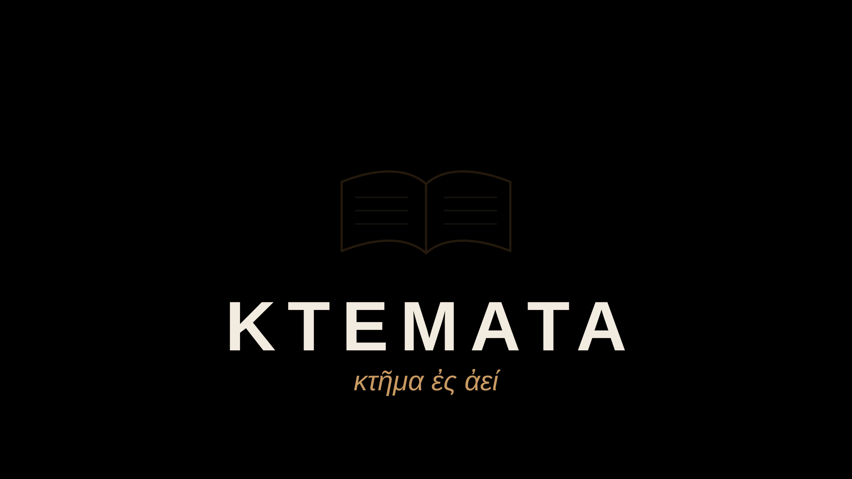
work/scripts/ktemata-wallpaper.png
