jsoeterbroek/ktemata/stl/ktemata_face.stl

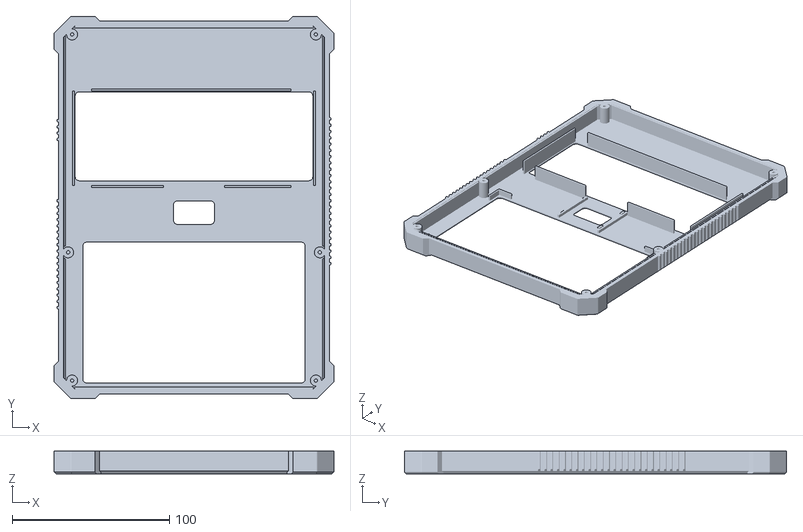
[picture p47: CAD file, 2026-10-24]
stl/ktemata_face.stl
178.0 x 243.0 x 14.4
