jsoeterbroek/ktemata/stl/r5/ktemata_r5_deck.stl

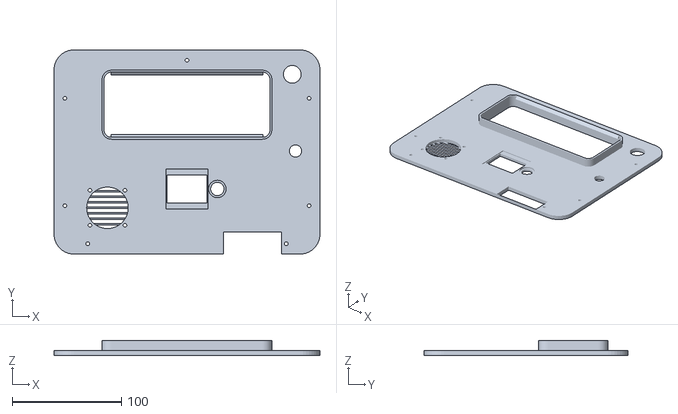
[picture p48: CAD file, 2026-11-14]
stl/r5/ktemata_r5_deck.stl
243.3 x 186.8 x 13.5
