jsoeterbroek/ktemata/stl/stencil/stencil_deck_deep_amber.stl

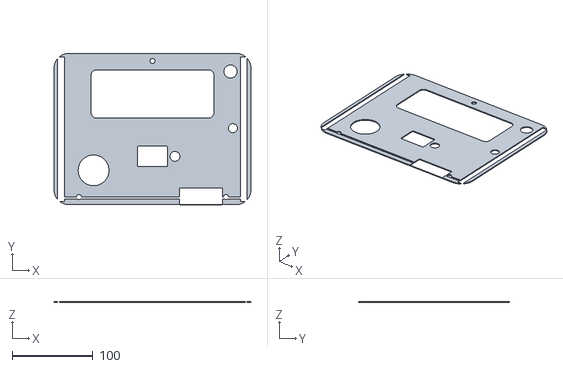
[picture p49: CAD file, 2026-11-14]
stl/stencil/stencil_deck_deep_amber.stl
243.3 x 186.8 x 1.20
