jsoeterbroek/ktemata/stl/ktemata_case.3mf

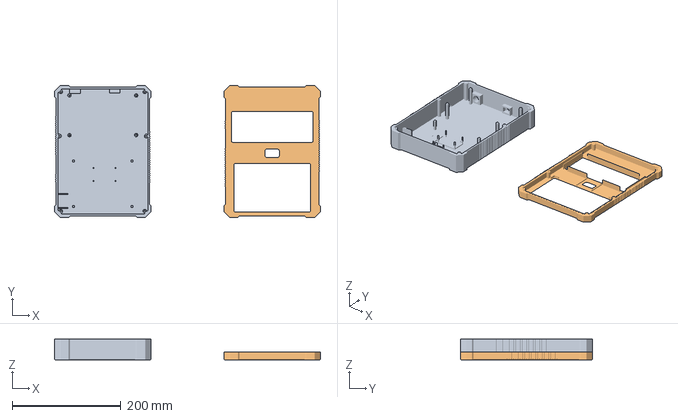
[picture p50: CAD file, 2026-10-24]
stl/ktemata_case.3mf
490.3 x 243.0 x 38.5 mm
ktemata_bottom.stl
ktemata_face.stl
