jsoeterbroek/ktemata/stl/r5/ktemata_r5_cass.3mf

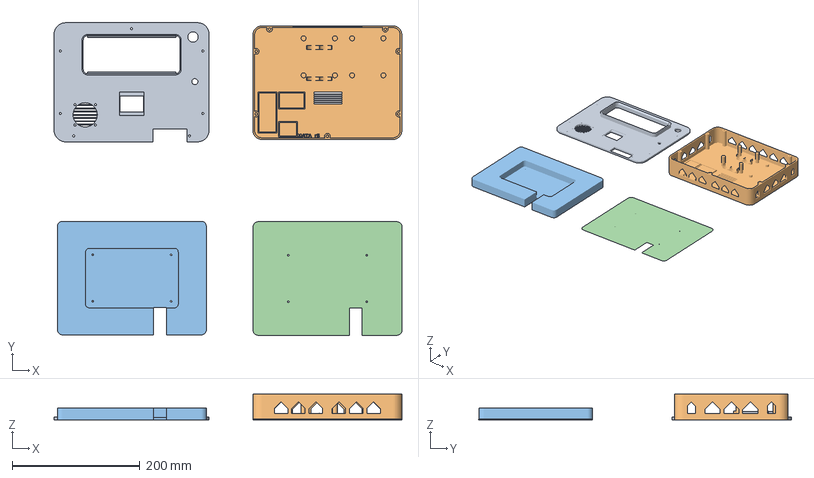
[picture p51: CAD file, 2026-11-11]
stl/r5/ktemata_r5_cass.3mf
545.5 x 490.1 x 40.4 mm
ktemata_r5_deck.stl
ktemata_r5_tray.stl
ktemata_r5_lid_cover.stl
ktemata_r5_lid_cover_test_dimensions.stl
