jsoeterbroek/ktemata/stl/ktemata_keyboard_support.stl

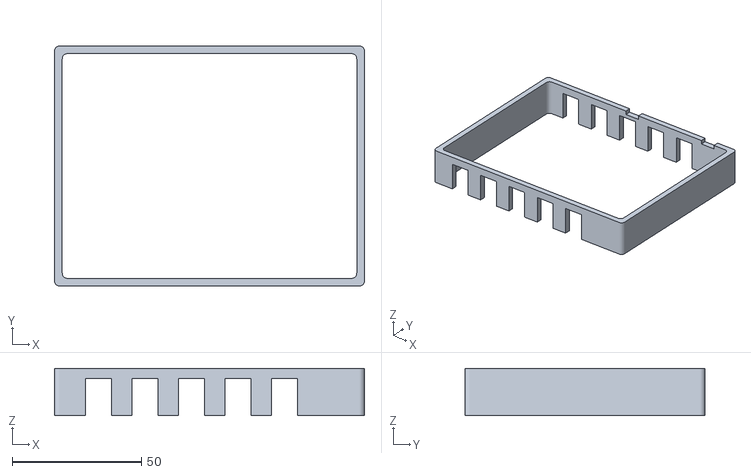
[picture p53: CAD file, 2026-10-24]
stl/ktemata_keyboard_support.stl
120.0 x 93.0 x 18.3
