jsoeterbroek/ktemata/stl/r5/ktemata_r5_lid_cover_waveshare_7in.stl

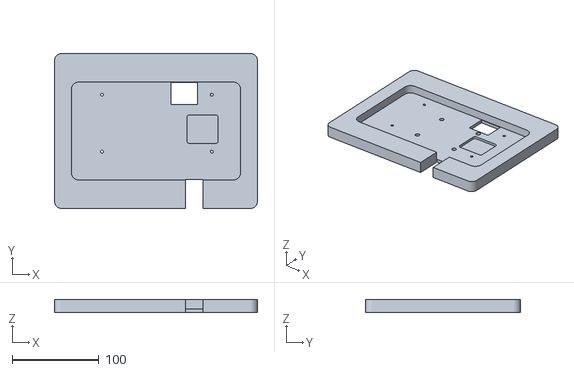
[picture p54: CAD file, 2026-11-10]
stl/r5/ktemata_r5_lid_cover_waveshare_7in.stl
233.5 x 178.1 x 14.5
