jsoeterbroek/ktemata/stl/stencil/stencil_deck_amber.stl

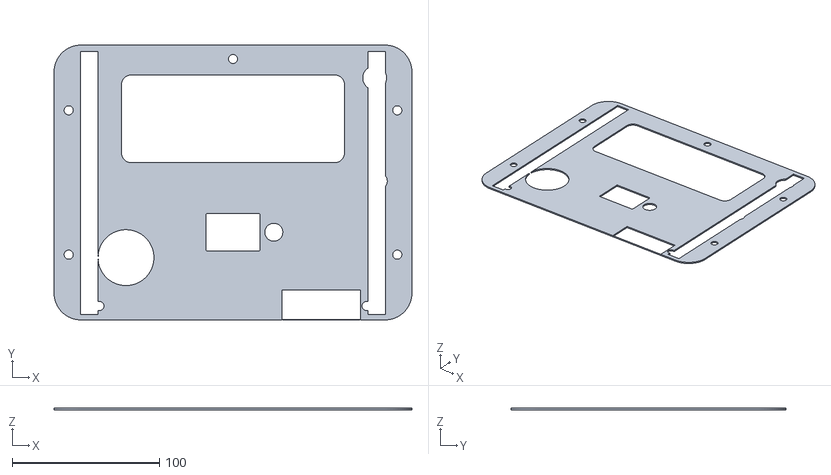
[picture p55: CAD file, 2026-11-14]
stl/stencil/stencil_deck_amber.stl
243.3 x 186.8 x 1.20
