jsoeterbroek/ktemata/stl/ktemata_corner_cup.stl

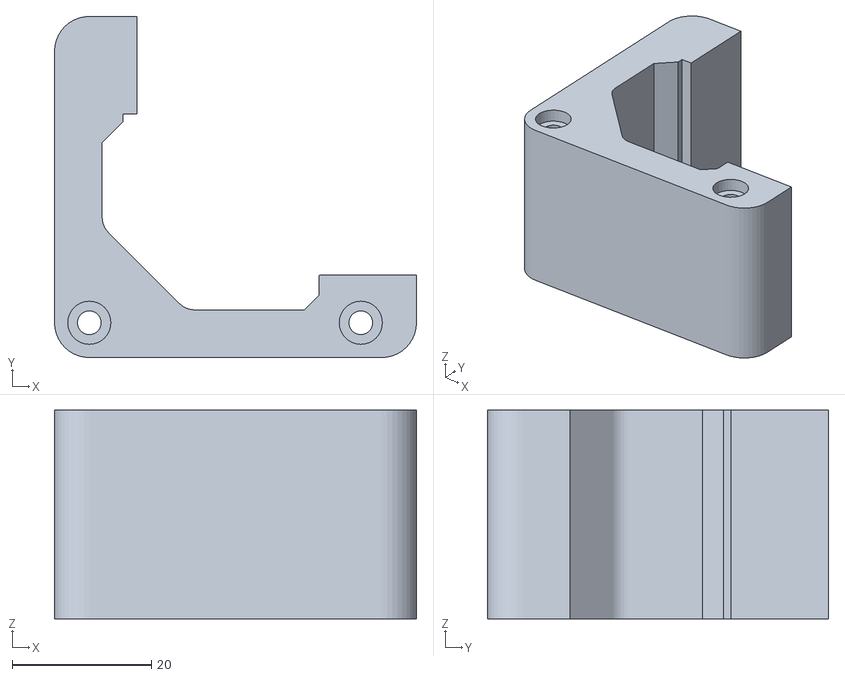
[picture p56: CAD file, 2026-10-24]
stl/ktemata_corner_cup.stl
52.0 x 49.0 x 30.0
