jsoeterbroek/ktemata/stl/r5/ktemata_r5_lid_cover.stl

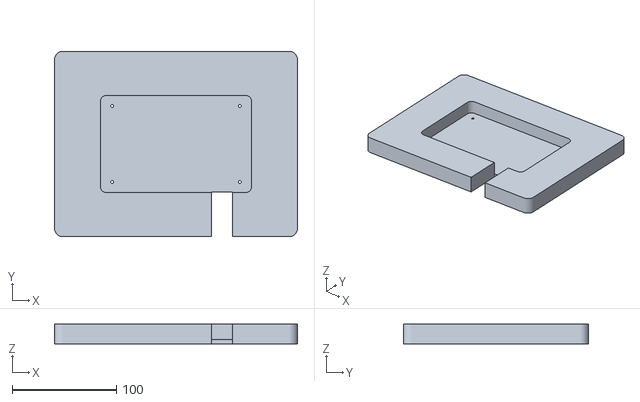
[picture p57: CAD file, 2026-11-10]
stl/r5/ktemata_r5_lid_cover.stl
233.5 x 178.1 x 18.9
