jsoeterbroek/ktemata/stl/stencil/stencil_deck_hairline.stl

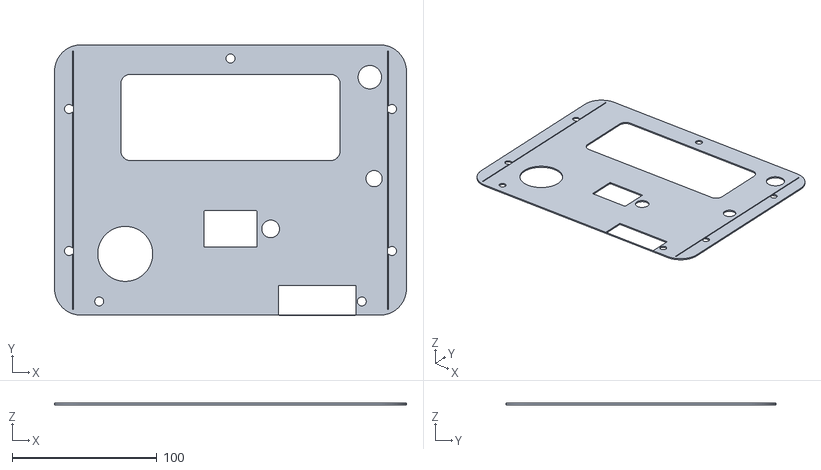
[picture p58: CAD file, 2026-11-14]
stl/stencil/stencil_deck_hairline.stl
243.3 x 186.8 x 1.20
