jsoeterbroek/ktemata/stl/ktemata_corner_lid.stl

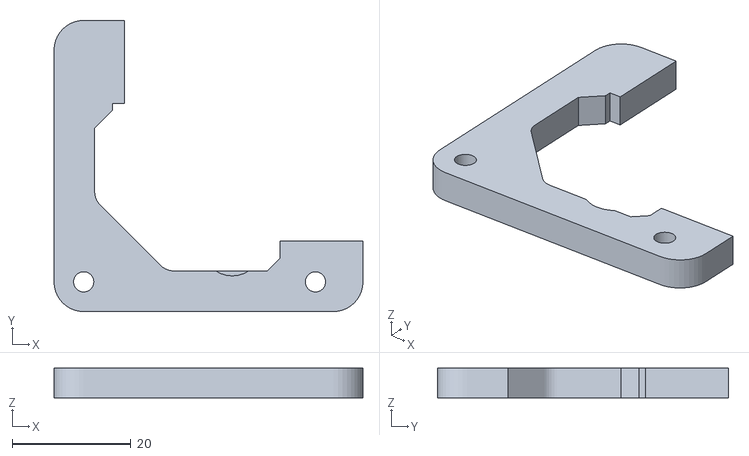
[picture p59: CAD file, 2026-10-24]
stl/ktemata_corner_lid.stl
52.0 x 49.0 x 5.00
