jsoeterbroek/ktemata/stl/r5/ktemata_r5_lid_plate.stl

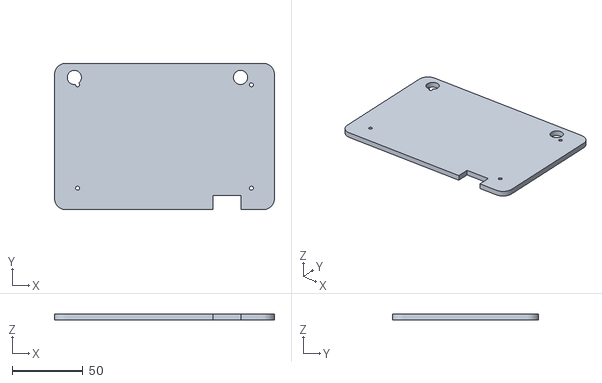
[picture p60: CAD file, 2026-11-10]
stl/r5/ktemata_r5_lid_plate.stl
155.4 x 103.5 x 4.00
