jsoeterbroek/ktemata/stl/ktemata_corner_cap.stl

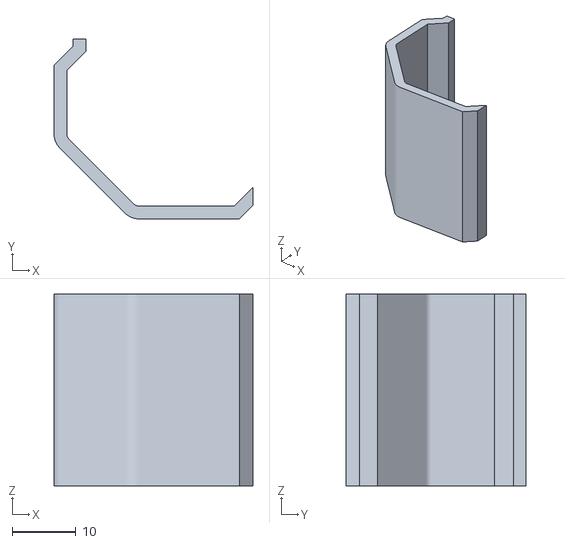
[picture p61: CAD file, 2026-10-24]
stl/ktemata_corner_cap.stl
31.1 x 28.1 x 30.0
