jsoeterbroek/ktemata/stl/r5/ktemata_r5_lid_cover_test_dimensions.stl

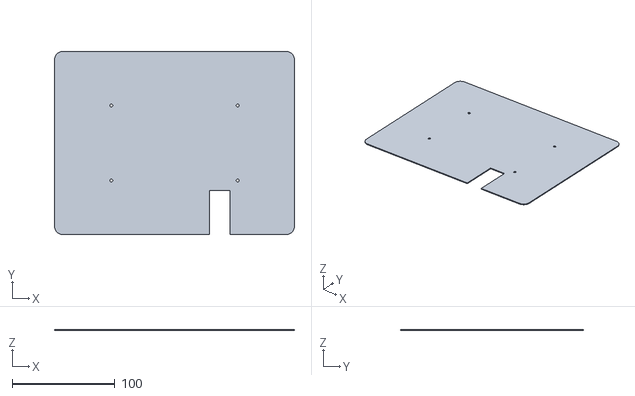
[picture p62: CAD file, 2026-11-10]
stl/r5/ktemata_r5_lid_cover_test_dimensions.stl
233.5 x 178.1 x 1.00
