jsoeterbroek/ktemata/stl/ktemata_corner_plate.stl

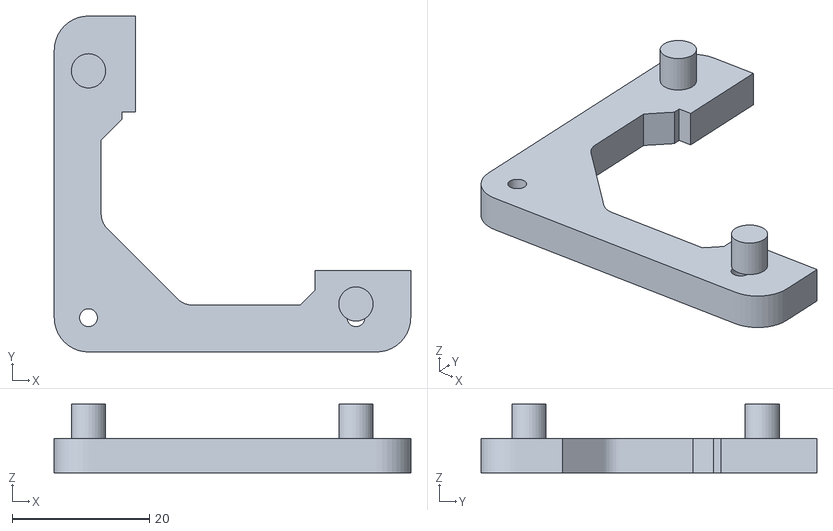
[picture p64: CAD file, 2026-10-24]
stl/ktemata_corner_plate.stl
52.0 x 49.0 x 10.0
