jsoeterbroek/ktemata/stl/r5/ktemata_r5_tray.stl

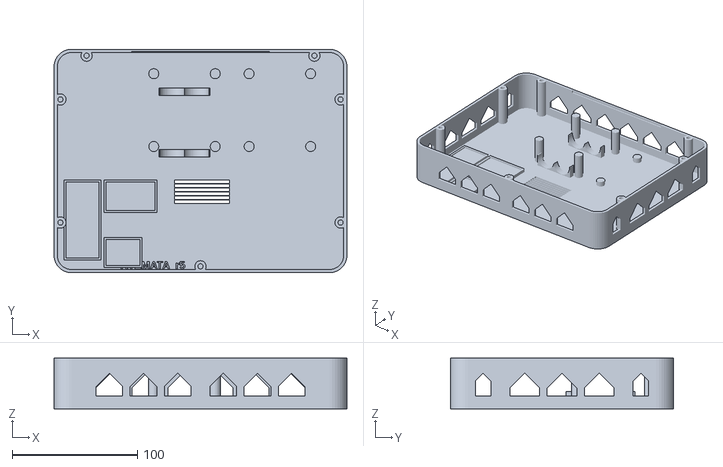
[picture p65: CAD file, 2026-11-05]
stl/r5/ktemata_r5_tray.stl
233.5 x 178.1 x 40.4
