jsoeterbroek/ktemata/stl/ktemata_bottom.stl

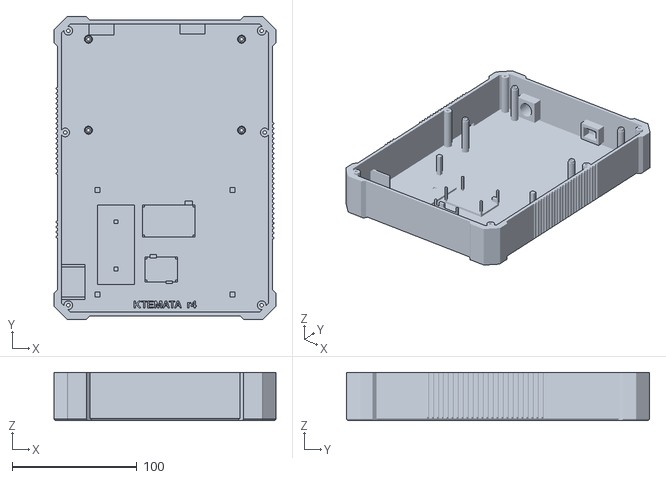
[picture p67: CAD file, 2026-10-23]
stl/ktemata_bottom.stl
178.0 x 243.0 x 38.5
