jsoeterbroek/ktemata/stl/stencil/stencil_cover_ash.stl

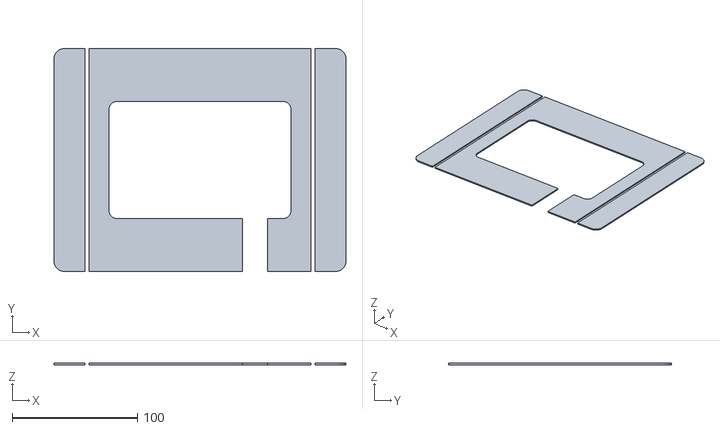
[picture p68: CAD file, 2026-11-10]
stl/stencil/stencil_cover_ash.stl
233.5 x 178.1 x 1.20
