jsoeterbroek/ktemata/stl/ktemata_charge_plug.stl

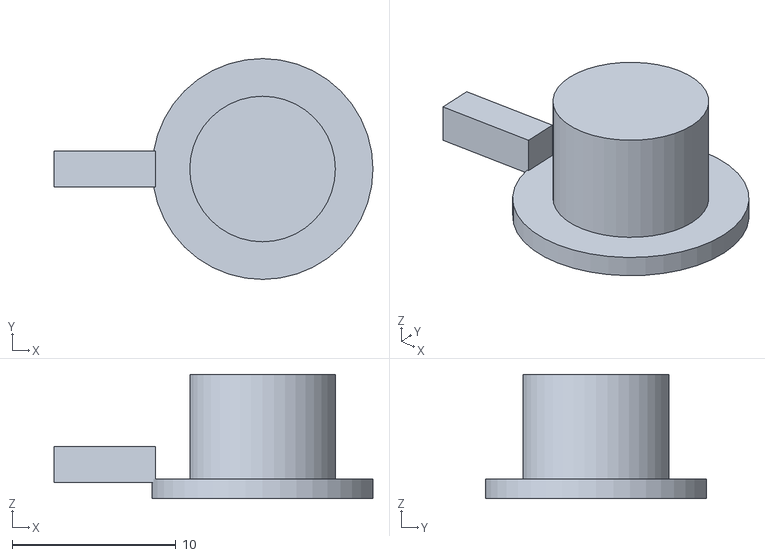
[picture p69: CAD file, 2026-10-23]
stl/ktemata_charge_plug.stl
19.5 x 13.5 x 7.60
