jsoeterbroek/ktemata/stl/stencil/stencil_cover_deep_amber.stl

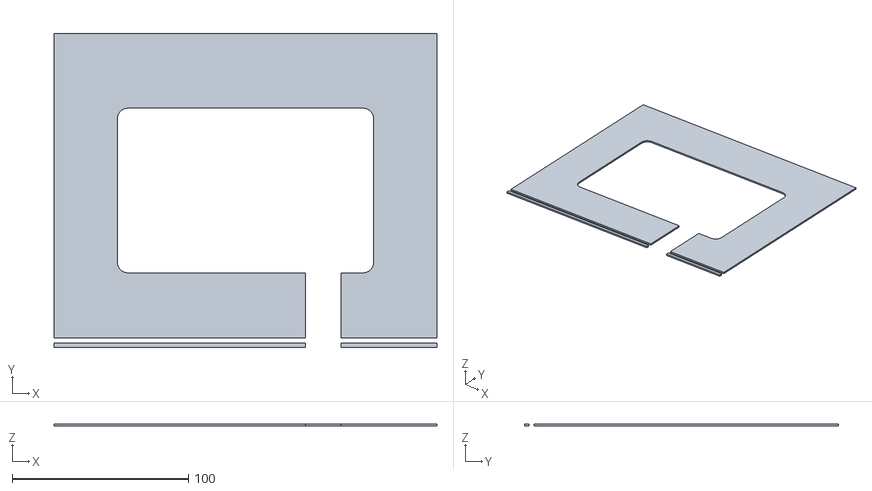
[picture p70: CAD file, 2026-11-10]
stl/stencil/stencil_cover_deep_amber.stl
217.4 x 178.1 x 1.20
