jsoeterbroek/ktemata/stl/ktemata_pull_switch.stl

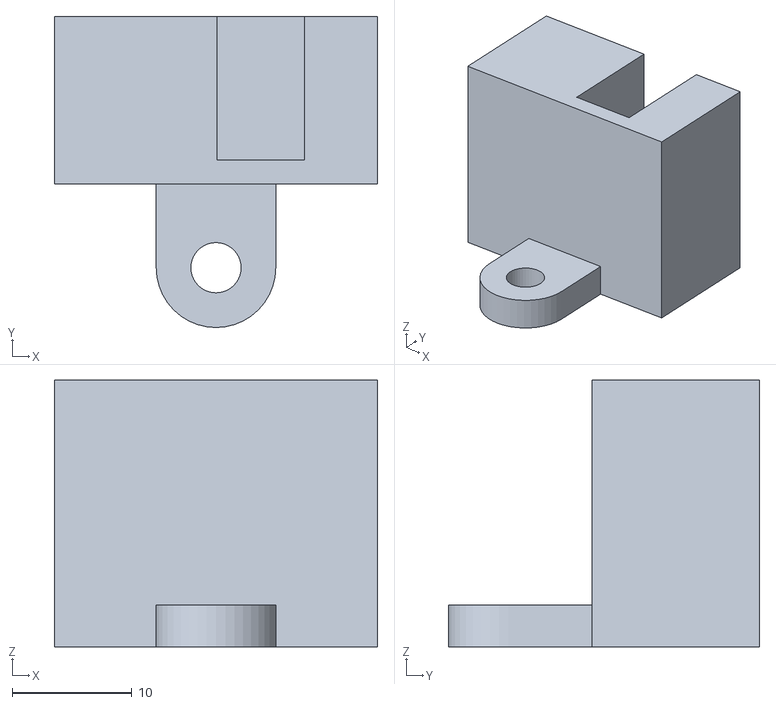
[picture p71: CAD file, 2026-10-16]
stl/ktemata_pull_switch.stl
27.0 x 26.0 x 22.3
