jsoeterbroek/ktemata/stl/ktemata_power_button.stl

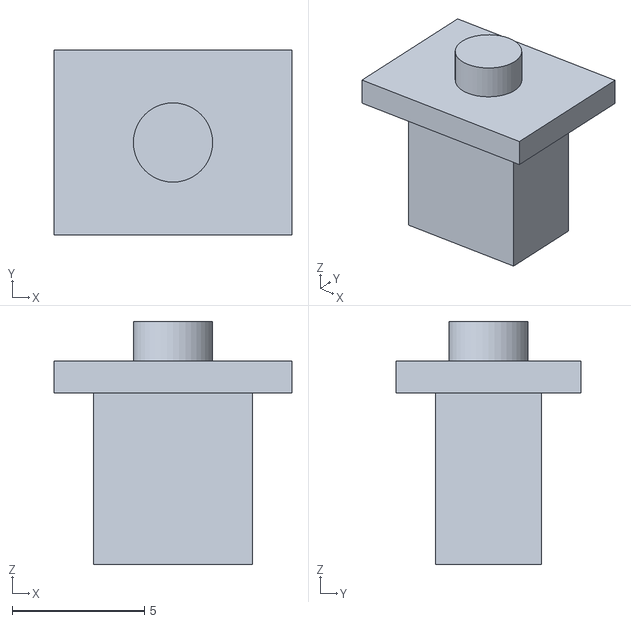
[picture p73: CAD file, 2026-10-16]
stl/ktemata_power_button.stl
9.00 x 7.00 x 9.20
