jsoeterbroek/ktemata/stl/stencil/stencil_cover_amber.stl

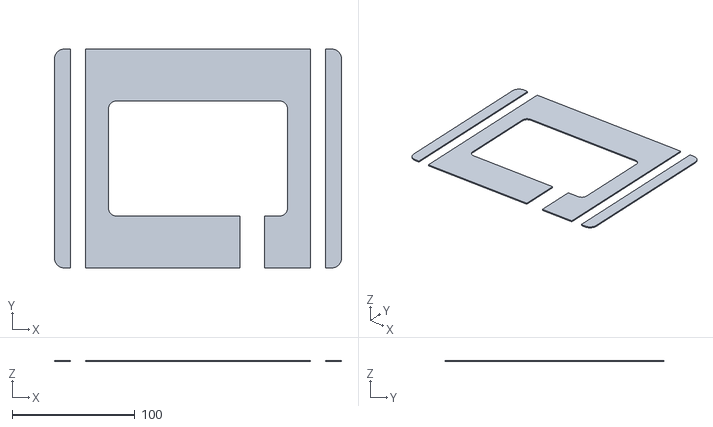
[picture p74: CAD file, 2026-11-10]
stl/stencil/stencil_cover_amber.stl
233.5 x 178.1 x 1.20
