jsoeterbroek/ktemata/stl/stencil/ktemata_r5_paint_stencils.3mf

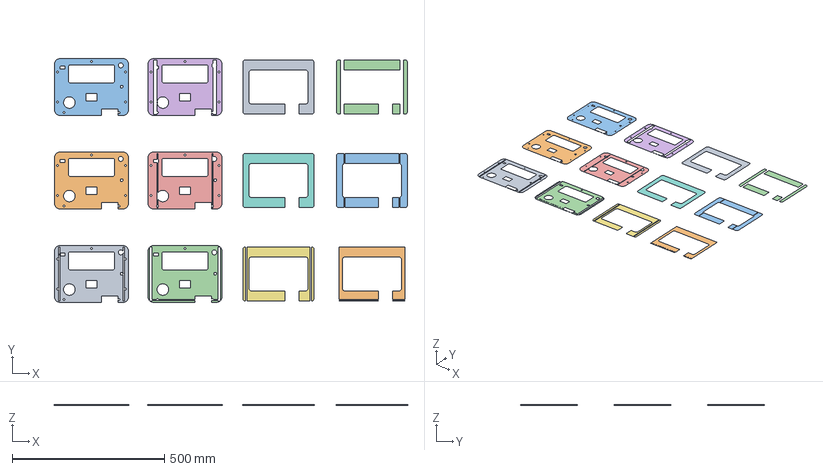
[picture p75: CAD file, 2026-11-08]
stl/stencil/ktemata_r5_paint_stencils.3mf
1160.0 x 801.2 x 1.20 mm
stencil_deck_slate.stl
stencil_deck_ink.stl
stencil_deck_hairline.stl
stencil_deck_deep_amber.stl
stencil_deck_ash.stl
stencil_deck_amber.stl
stencil_cover_slate.stl
stencil_cover_ink.stl
stencil_cover_hairline.stl
stencil_cover_deep_amber.stl
stencil_cover_ash.stl
stencil_cover_amber.stl
