jsoeterbroek/ktemata/(list of files, cad)

Other CAD files:
stl/stencil/stencil_deck_ink.stl
stl/stencil/stencil_cover_ink.stl
