jsoeterbroek/ktemata/renders/r5/r5_assembly.png

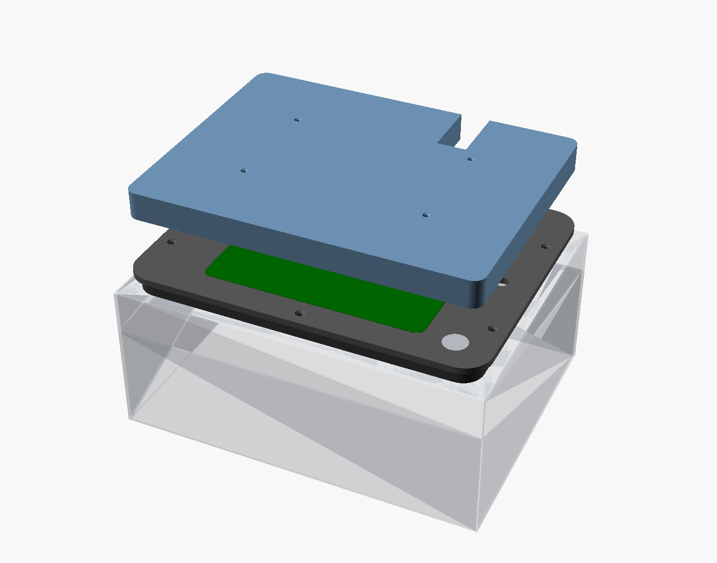
renders/r5/r5_assembly.png
