jsoeterbroek/ktemata/docs/pi_flux_r2_wiring.kicad_sch

## KiCad design docs/pi_flux_r2_wiring.kicad_sch (2026-10-19)

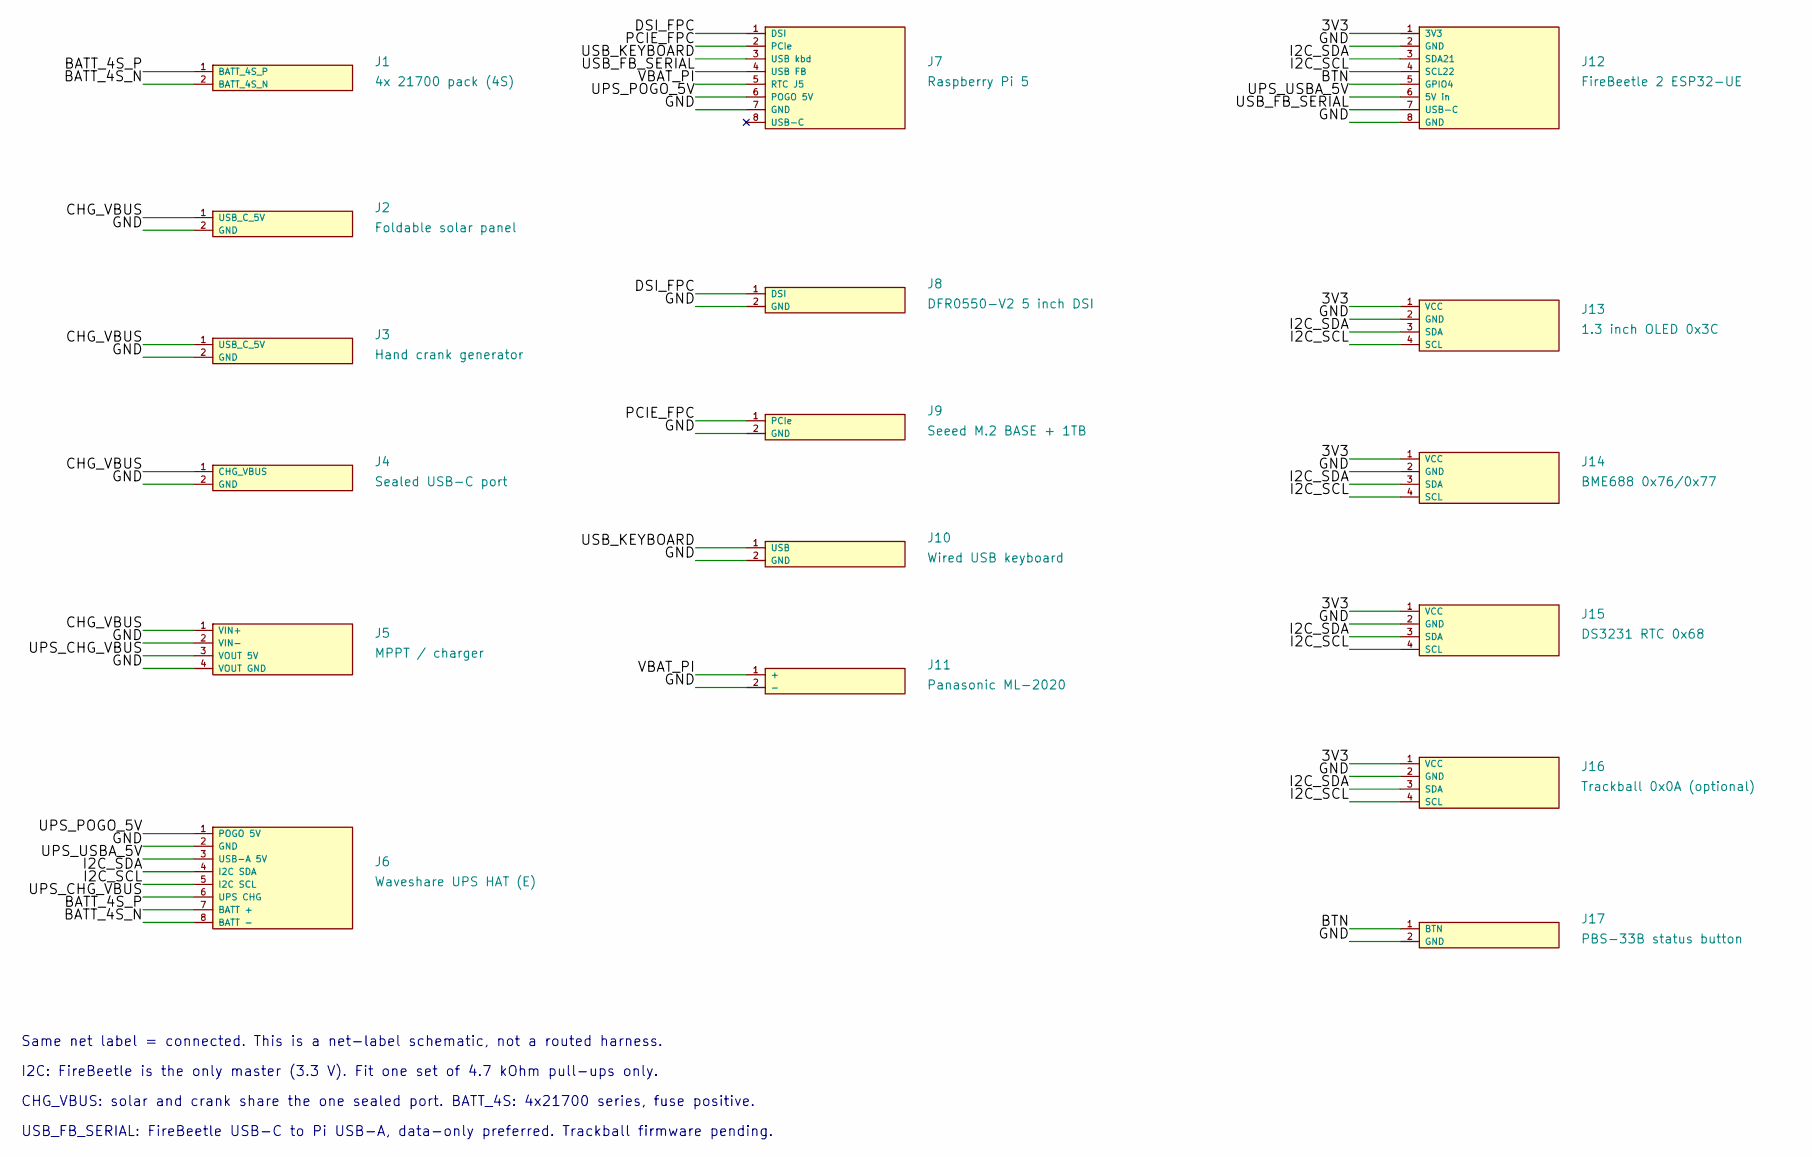
[picture p78: schematic pi_flux_r2_wiring.kicad_sch]

Parts:
J1: 4x 21700 pack (4S)
J2: Foldable solar panel
J3: Hand crank generator
J4: Sealed USB-C port
J5: MPPT / charger
J6: Waveshare UPS HAT (E)
J7: Raspberry Pi 5
J8: DFR0550-V2 5 inch DSI
J9: Seeed M.2 BASE + 1TB
J10: Wired USB keyboard
J11: Panasonic ML-2020
J12: FireBeetle 2 ESP32-UE
J13: 1.3 inch OLED 0x3C
J14: BME688 0x76/0x77
J15: DS3231 RTC 0x68
J16: Trackball 0x0A (optional)
J17: PBS-33B status button

Connections:
3V3: J12.1 (3V3), J13.1 (VCC), J14.1 (VCC), J15.1 (VCC), J16.1 (VCC)
BATT_4S_N: J1.2 (BATT_4S_N), J6.8 (BATT -)
BATT_4S_P: J1.1 (BATT_4S_P), J6.7 (BATT +)
BTN: J12.5 (GPIO4), J17.1 (BTN)
CHG_VBUS: J2.1 (USB_C_5V), J3.1 (USB_C_5V), J4.1 (CHG_VBUS), J5.1 (VIN+)
DSI_FPC: J7.1 (DSI), J8.1 (DSI)
GND: J2.2 (GND), J3.2 (GND), J4.2 (GND), J5.2 (VIN-), J5.4 (VOUT GND), J6.2 (GND), J7.7 (GND), J8.2 (GND), J9.2 (GND), J10.2 (GND), J11.2 (-), J12.2 (GND), J12.8 (GND), J13.2 (GND), J14.2 (GND), J15.2 (GND), J16.2 (GND), J17.2 (GND)
I2C_SCL: J6.5 (I2C SCL), J12.4 (SCL22), J13.4 (SCL), J14.4 (SCL), J15.4 (SCL), J16.4 (SCL)
I2C_SDA: J6.4 (I2C SDA), J12.3 (SDA21), J13.3 (SDA), J14.3 (SDA), J15.3 (SDA), J16.3 (SDA)
PCIE_FPC: J7.2 (PCIe), J9.1 (PCIe)
UPS_CHG_VBUS: J5.3 (VOUT 5V), J6.6 (UPS CHG)
UPS_POGO_5V: J6.1 (POGO 5V), J7.6 (POGO 5V)
UPS_USBA_5V: J6.3 (USB-A 5V), J12.6 (5V in)
USB_FB_SERIAL: J7.4 (USB FB), J12.7 (USB-C)
USB_KEYBOARD: J7.3 (USB kbd), J10.1 (USB)
VBAT_PI: J7.5 (RTC J5), J11.1 (+)

Notes on the sheet:
Same net label = connected. This is a net-label schematic, not a routed harness.
I2C: FireBeetle is the only master (3.3 V). Fit one set of 4.7 kOhm pull-ups only.
CHG_VBUS: solar and crank share the one sealed port. BATT_4S: 4x21700 series, fuse positive.
USB_FB_SERIAL: FireBeetle USB-C to Pi USB-A, data-only preferred. Trackball firmware pending.
