jsoeterbroek/ktemata/(commit log)

2026-10-16 Pi Fluks/AI: parametric OpenSCAD case for the Pi Flux r1 handheld
    Rugged re-creation of the Pi Flux r1 case (corner bumpers, chamfered
    edges, grip ribs), with printable STLs, renders and export/check tooling.
    [assembly.scad, bottom.scad, common.scad, export.scad, face.scad, keyboard_support.scad, pi_flux_bottom.stl, pi_flux_face.stl]
2026-10-16 Rename pi_flux_* files to pi_fluks_*, refresh renders
    - STLs and renders renamed to pi_fluks_* (export.py, README updated)
    - add cad/tools/render.py to regenerate every image in renders/
    - all renders now show the rugged design; fixed the empty section view
    - check.sh no longer hard-codes the project path
    [pi_fluks_bottom.stl, pi_fluks_face.stl, pi_fluks_keyboard_support.stl, pi_fluks_power_button.stl, pi_fluks_pull_switch.stl, pi_flux_bottom.stl, pi_flux_face.stl, pi_flux_keyboard_support.stl]
2026-10-16 Fix non-manifold edges in bottom and face STLs
    - side case-screw bosses moved to x=6 so they overlap the wall instead of
    touching it along a line (18+ non-manifold edges in Bambu Studio)
    - port box gets a pad that fuses it into the top wall
    - export.py now also counts edges shared by more than two faces
    [bottom.scad, common.scad, pi_fluks_bottom.stl, pi_fluks_face.stl, pi_fluks_keyboard_support.stl]
2026-10-16 Add Bambu Studio project for the bottom part
    [pi_fluks_bottom.3mf]
2026-10-16 Add Bambu Studio project for the face part
    [pi_fluks_face.3mf]
2026-10-16 Docs: r2 target hardware (Pi 5, DSI LCD, UPS + solar, wired USB keyboard)
    Choose Raspberry Pi 5 over ZimaBlade, drop e-paper, and document
    recommended display, UPS/solar power, wired keyboard, sensors, storage
    and RTC. Update the face 3MF.
    [pi_fluks_face.3mf]
2026-10-16 Docs: nice-to-haves LilyGO OLED for sensor readings and Meshtastic
2026-10-18 Docs: solar plus separate hand crank generator for recharging
    Add the hand crank as a backup source sharing the solar MPPT input and
    the sealed USB-C port; track generator video transcripts.
2026-10-18 Docs: Pi 5 4 GB, status OLED with battery status, drop Meshtastic
    Drop Meshtastic and the radio switch; the LilyGO OLED now shows battery
    status and environment readings with warnings. Record why the Pi 4 was
    rejected and set the Pi 5 RAM to 4 GB.
2026-10-19 r2 CAD updates and status-OLED firmware
    - model the r2 case: DFR0550-V2, UPS HAT (E), 4x21700, FireBeetle tray, sealed charge plug, 1.3" OLED window and PBS-33B button
    - add the PlatformIO status-OLED firmware for the FireBeetle 2 ESP32-UE (N16R2): SH1106 OLED, BME688/DS3231/UPS HAT drivers, button, alerts and serial telemetry
    - regenerate r2 STLs and renders; update hardware, wiring and bring-up docs
    [assembly.scad, bottom.scad, charge_plug.scad, common.scad, export.scad, face.scad, keyboard_support.scad, pi_fluks_bottom.stl]
2026-10-19 add BOM
2026-10-19 Add r2 wiring diagrams, KiCad schematic and connection list
    [pi_flux_r2_connections.csv, pi_flux_r2_wiring.kicad_sch]
2026-10-19 Fix OLED clock timezone handling for Europe/Amsterdam
    [config.h, main.cpp]
2026-10-20 Name the Phistone keyboard build r3
    [common.scad]
2026-10-20 Update README CAD implementation for r3
    r3 is the current target: same mechanics and STLs as r2, with the Phistone
    Mini Keyboard (2.4 GHz dongle or Bluetooth). Document that there is no R3
    switch (R2=true selects the shared r2/r3 geometry), keep the stack/depth
    notes valid for both builds, and state the keyboard as the only difference
    (no internal keyboard cable, no r2 trackball, side cutout still off).
2026-10-20 Retitle BOM for the r3 build
    BOM.md now scopes the r3 target: r3 shares the r2 mechanics/STLs and differs
    in the Phistone keyboard (2.4 GHz dongle or Bluetooth, no trackball). The
    Phistone row moves to the top of section C as the r3 standard, the r2 wired
    keyboard alternatives are labelled as such, and the keyboard-USB cable drops
    from 2 to 1 because r3 needs none. AGENTS.md and the README BOM pointer now
    reference the r3 CAD section.
2026-10-20 Retarget wiring diagrams and schematic for the r3 build
    Rename the KiCad schematic, PDF, PNG, SVG and netlist CSV to pi_flux_r3_*;
    rev 2 carries the r3 title and a Phistone 2.4G dongle block (J10) on the
    USB_KEYBOARD net. The r2-only trackball J16 is marked DNP (crossed out) and
    the notes state that r3 uses no trackball.
    Regenerate the Graphviz data/power diagrams: the keyboard node is now the
    Phistone (dongle or Bluetooth, no cable, own battery), the trackball node is
    gone, and the power diagram carries an r3 keyboard-power note. WIRING.md
    documents the wireless keyboard link, drops the keyboard from the common-
    ground rule, and adds an r3 keyboard-link check; README points at the r3
    artif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
    [pi_flux_r3_connections.csv, pi_flux_r3_wiring.kicad_sch]
2026-10-21 rebuild for r3
    [pi_fluks_bottom.3mf, pi_fluks_face.3mf]
2026-10-21 Add hand crank generator CAD (separate backup unit)
    Parametric OpenSCAD model of the 3:1 geared axial-flux hand crank
    generator, a separate unit that feeds the case's sealed USB-C charge
    port. Two 8-magnet rotors turn either side of an 8-coil stator; a
    66T:22T spur pair (1.5 mm module, 0.4 mm backlash) drives the rotor from
    the crank. Rectifier, buffer caps and a 5 V module sit in a tray under
    the base plate.
    Parts (cad/crank_*.scad, exported to stl/crank/, all manifold):
    base, stator, top, rotor (x2), hub (x2), gear_big, gear_small, arm,
    knob, tray, lid, foot (x4).
    - crank_common.scad: parameters and helpers (involute gear profile,
    D-bore, clamp hub); every z level derived from the comp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
    [crank_arm.scad, crank_arm.stl, crank_assembly.scad, crank_base.scad, crank_base.stl, crank_common.scad, crank_foot.stl, crank_gear_big.stl]
2026-10-21 Crank: fix hub screws, add spacer part, document the build order
    The assembly documentation existed but described a sequence that could
    not be built:
    - The 4 disc-to-hub screws had no head clearance: the rotor-to-stator
    gap is 0.6 mm and an M3 socket head is 3.0 mm. The rotor now has a
    6.2 mm counterbore in the magnet face, so the heads sit flush, and the
    screws go in from that face (before the stator is fitted).
    - The M6 knob nut trap opened into the arm's top face with the knob bolt
    through it; it now opens at the underside, where the nut can be held.
    - The four spacer tubes were "buy or print" with no printed part; add
    crank_spacer (the set is now 13 parts).
    - Remove a 0.2 mm s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
    [crank_arm.scad, crank_arm.stl, crank_assembly.scad, crank_base.stl, crank_common.scad, crank_foot.stl, crank_hub.scad, crank_hub.stl]
2026-10-21 Add ZIM library tool; fix the lxml build failure
    The failed compile was lxml built from source against libxml2 2.15: its
    generated C passes xmlChar** where const xmlChar** is expected. That only
    affects lxml <= 5.2.2 (6.1.3 builds clean); no lxml-based ZIM reader is
    needed here.
    work/scripts/zim.py inspects the Kiwix library with libzim, which ships
    prebuilt wheels so nothing is compiled:
    zim.py table of the library (title, date, languages,
    entries, size) plus totals
    --check verify every archive checksum
    --missing / --extra diff the disk against zim/zim.md
    --update-list rewrite the zim.md list from the disk
    It uses all_entr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
2026-10-21 Add Bambu Studio project for the crank tray and base
    Two plates on a P1S (0.20mm Strength, PLA Basic): plate 1 the
    electronics tray, plate 2 the base plate. Meshes verified identical to
    the current stl/crank/crank_tray.stl and crank_base.stl.
    [handcrank.3mf]
2026-10-22 add 3mf file
    [handcrank.3mf]
2026-10-22 Retarget the case to r4: Touch Display 2 + UPS HAT (B) + Rii K06
    The 22 Oct 2026 order replaces the display, power board, cells and keyboard,
    so r4 needs its own geometry rather than another r2 variant.
    - common.scad: add the R4 switch beside R2, with pick(r4, r2r3, r1) for every
    variant-dependent value. r4 stack: 2x 18650 on the HAT (B) holder side
    (23.35 mm), 6 mm pogo gap, Pi, 8.5 mm display standoffs, 6.42 mm panel.
    Envelope 172 x 237 x 53 mm; split plane at 38.55 mm so the 14.92 mm display
    is not cut and the face part stays whole.
    - The HAT (B) has the same 85 x 56 outline as the Pi, so it is mounted rotated
    90 degrees (56 x 85); aligned, its board collides with the Pi port b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
    [assembly.scad, bottom.scad, charge_plug.scad, common.scad, face.scad, keyboard_support.scad, pi_fluks_bottom.stl, pi_fluks_charge_plug.stl]
2026-10-23 Move the hand crank generator to its own repository
    The crank is a separate unit that happened to be developed here: it is not in
    the case, shares no code with it, and only its output cable connects to the
    sealed charge port. Split it out to github.com/jsoeterbroek/handcrank (with its
    git history preserved via git filter-repo).
    Removed here:
    - cad/crank_*.scad, cad/export_crank.scad, cad/tools/export_crank.py
    - docs/CRANK.md (now the handcrank README)
    - stl/crank/ (13 STLs + the Bambu 3MF project; the newer local 3MF went across)
    - renders/crank_*.png
    - the two generator transcripts in reference/yt/
    Adjusted:
    - cad/tools/render.py: drop the crank views; point at the new repo.
    - README/AGEN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
    [assembly.scad, bottom.scad, crank_arm.scad, crank_arm.stl, crank_assembly.scad, crank_base.scad, crank_base.stl, crank_common.scad]
2026-10-23 Rename the project to Ktemata
    Ktemata (Greek kappa-tau-eta-mu-alpha-tau-alpha, "possessions") comes from Thucydides'
    kappa-tau-eta-mu-alpha epsilon-sigma alpha-epsilon-iota, "a possession for all time".
    The device is an offline library that survives the loss of power and networking,
    which is what that phrase claims for a written record.
    - Wordmark: the face and the bottom shell now emboss Kappa-Tau-Eta-Mu-Alpha-Tau-Alpha
    instead of the old pi-FLUKS/AI mark; the motto becomes the Thucydides phrase
    (Liberation Sans has the Greek glyphs, so no new font dependency).
    - Files: stl/ and renders/ are ktemata_*; the KiCad schematic, PDF, PNG, SVG and CSV
    are ktemata_r3_* (regenerated with kica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
    [assembly.scad, bottom.scad, charge_plug.scad, common.scad, face.scad, keyboard_support.scad, ktemata_bottom.3mf, ktemata_bottom.stl]
2026-10-23 Add KTEMATA logo to README and switch imprints to Latin capitals
    - docs/ktemata-logo.svg: centred lockup (device, KTEMATA wordmark, motto)
    - README: logo above the title; wordmark references updated
    - cad/face.scad, cad/bottom.scad: engrave KTEMATA instead of ΚΤΗΜΑΤΑ
    - re-export face/bottom STLs and the affected renders
    [bottom.scad, face.scad, ktemata_bottom.stl, ktemata_face.stl]
2026-10-23 Add barebones ktemata.org website
    Static site in site/: logo lockup, device description, the name, GitHub link and a
    use-at-your-own-risk disclaimer. Deployed to www/ on the Transip host.
2026-10-23 add charge and hand krank
2026-10-23 Record the 23 Oct order: M.2 BASE, SN740 512 GB, ML-2020
    - BOM: add the 23 Oct Kiwi (BASE, RTC cell, Qw/ST cables) and Bol (SN740,
    5 V adapter) lines; the HAT (B) ships with its 8.4 V / 2 A supply, and the
    5 V 3 A OTRONIC adapter is the wrong voltage, wrong barrel and has no Pi 5
    input; prune the gaps, correct the subtotals
    - BOM/README/WIRING/R4: storage is now the 512 GB M.2 2242 drive, with the
    capacity limit (477 GiB vs the 833 GiB library) and the missing NVMe bay
    called out; OLED storage screen references 512 GB
2026-10-24 consolidated 3mf file
    [ktemata_bottom.3mf, ktemata_case.3mf, ktemata_face.3mf]
2026-10-24 Document the slimming options (not implemented)
    docs/SLIMMING.md records why r4 keeps its 53 mm stack: the thickness is set
    by the 2x18650 block and the Touch Display 2, not by the pogo pins. Unstacking
    the HAT beside/below the keyboard saves ~6.5 mm (T ~46.5) at the cost of the
    floor plan; a 2S pouch pack is the only route to ~35-40 mm. Linked from the
    README and the r4 NVMe caveat.
2026-10-24 Add a silicone corner overmould tool
    cad/corner_mould.scad casts one soft-rubber corner cap at a time onto the
    existing r4 bumper, using the printed case as the inner mould half:
    - cm_plate: bottom seal, bore hugs the case at CM_FIT
    - cm_cup: cavity whose inner surface IS the cap's outer surface
    - cm_lid: top seal with a fill port and air vent
    z-split rather than a diagonal split, because the corner cross-section is only
    prismatic along z. The rubber is a 2 mm sleeve from z=5 to z=35 (≈3.3 ml per
    corner), so it covers the seam and clears the edge chamfer.
    Verified: cap/cup/plate/lid are manifold (bad edges 0) and every pair is either
    clear or tangent - no volumetric overlap. Cap reach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
    [corner_mould.scad, corner_mould_check.scad, export.scad, ktemata_corner_cap.stl, ktemata_corner_cup.stl, ktemata_corner_lid.stl, ktemata_corner_plate.stl]
2026-10-24 Corner mould: correct the screw length in the docs
    M3 x 40 (5 lid + 30 cup + 5 plate) is what the stack needs, not 45.
    [corner_mould.scad]
2026-10-24 Corner mould docs: fix the silicone volume and the per-corner reuse wording
2026-10-24 check.sh: judge the corner mould by intersection volume
    The plates and the cavity touch the rubber over large faces, so the bbox
    flatness rule always reported a HIT for cup:cap, plate:cap and lid:cup. The
    intersection volume is exactly 0 for all three (surface tangency), which is
    what the tool needs; a real intrusion would show as a positive volume.
    Also fixes the inline vertex parser, which collected only x and then sliced
    it as x/y/z, producing impossible bboxes.
2026-10-24 check.sh: robust STL reporting, private scratch dir
    - move the inline Python into work/scripts/stl_report.py (the heredoc-quoting
    kept breaking the script mid-run)
    - mktemp -d per run: concurrent runs no longer overwrite each other's STLs
    - a missing STL now reports ERR instead of a Python traceback
    - corner mould pairs are judged by intersection volume and reported as OK when
    tangent, including the degenerate no-triangle contact of plate:cap
2026-10-24 Add Ubuntu/Raspberry Pi OS post-install script
    work/scripts/post-install.sh, after the shape of tprasadtp/ubuntu-post-install
    but one file with no YAML or menu:
    1. platform check (Debian/Ubuntu derivative)
    2. system update first: apt-get update + non-interactive full-upgrade
    3. install kiwix-tools (+ the kiwix desktop app)
    4. create /srv/kiwix/zim and the kiwix system user
    5. write and enable kiwix.service (kiwix-serve, hardened, gated on *.zim)
    6. optional display rotation and sample ZIM
    7. verify: throwaway kiwix-serve must answer
    Rotation: --rotate left|right|inverted|normal. "left" is 90 deg counter-clockwise,
    mapped to the kernel's clockwise rotate=270. Writes
    video=DSI-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
2026-10-24 Add the kiosk launcher, installed by --kiosk
    work/scripts/kiwix-kiosk.sh boots the device straight into the offline library:
    - refuses to start without a session
    - blanking off: xset on X11, wlopm on Wayland
    - optional wlr-randr --transform for the compositor (post-install passes --rotate's angle)
    - waits for kiwix-serve, then starts a borderless full-screen browser, falling back
    chromium -> chromium-browser -> firefox -> epiphany; or kiwix-desktop with --app kiwix
    - --selftest (exit 0 ready / 1 not), --stop, log in $XDG_STATE_HOME/ktemata/kiosk.log
    post-install.sh --kiosk installs it as /usr/local/bin/kiwix-kiosk, writes
    ~/.config/autostart/kiwix-kiosk.desktop for --kiosk-user (default: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
2026-10-24 Run hardware checks before the install
    The post-install now starts with a hardware report, before anything is upgraded or added,
    so it describes the machine as it arrived.
    Checks (PASS/FAIL/SKIP each): Pi model, throttle flags and SoC temperature via vcgencmd,
    DSI connector + mode, I2C buses and the expected addresses (0x42 UPS INA219, 0x3C/0x3D
    OLED, 0x68 DS3231, 0x76/0x77 BME688), the Pi RTC epoch, free space and a non-empty ZIM
    library, network links and whether kiwix-serve's port is listening.
    Findings never block the install. --hwtest-only reports and exits without root or
    changes; --strict makes failures exit non-zero; --no-hwtest skips them.
    Fixes found while testing:
    - i2cdetect l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
2026-10-24 Thermal findings are warnings, and name the actual power path
    85.6 C on a bare Pi 5 at room temperature is at the hard limit (85 C), but this build has
    no cooler by design (the UPS HAT (B) occupies the component side), so it is not a fault:
    - sample the temperature 5x instead of trusting one reading
    - PASS < 80 C, WARN at the soft (80) and hard (85) limits, with the load average attached
    - only UNDERVOLTAGE (throttle bits 0/16) is a FAIL; thermal/clock bits are warnings
    - --strict now fails on faults only, not on heat; warnings are counted separately
    - an idle reading at 85 C is called out, because idle should be well under 80
    Power hints: the Pi cannot detect the UPS HAT (B) - the INA219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
2026-10-24 Tell idle heat from load heat in the thermal check
    With the 27 W PSU fitted and no throttle flags, 85.6 C is not an undervoltage or a
    missing-cooler story: an idle Pi 5 runs 55-70 C. Distinguish the causes:
    - measure actual CPU busy time (two /proc/stat samples), not load average
    - >= 85 C while busy -> WARN (expected without a cooler)
    - >= 85 C while idle -> FAIL ("not load related"), with what to look at
    - 80-85 C while idle -> WARN (warm for idle)
    - on WARN/FAIL, list processes using >= 10% CPU (top 3)
    Verified with a harness: 85.6 C at 1% -> FAIL, 85.6 C at 85% -> WARN, 82 C at 2% ->
    WARN, 55 C -> PASS.
2026-10-24 Fix the display name, the browser package and the hints
    Reported from a real Pi 5 running Debian 13:
    - the DSI connector printed "2" instead of DSI-1: ${d##*/card*-} consumes through the
    last dash. Strip the card<N>- prefix separately.
    - chromium-browser does not exist on Debian (it is an Ubuntu snap transition) and
    chromium does not exist on Ubuntu, so ask apt which one the archive has; never fail
    the install over it
    - hwtest-only does not install anything, so the i2c SKIP now names the package to add
    - the trickle-charge note reads as a defect next to a working RTC; reword it
    Verified on Debian 13 (trixie) in a container: kiwix-tools 3.7.0 installed, chromium
    chosen and found by th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
2026-10-24 Correct the K06 to 151 x 59 x 11 and move the pocket into the face
    The 155 x 89 x 16.5 figure came from Rii's K06 product page, which is actually the
    i4's dimensions. The K06 manual (K06BT.pdf v1.2) says 151 x 59 x 11, 98 g, 400 mAh,
    and the product photos agree with the 2.56:1 outline.
    Consequences:
    - KB_BODY/KB_PCB 151 x 59 x 11; the 151 mm body still fits the existing 172 mm
    width, so the outer envelope is unchanged and a printed bottom shell still fits
    - the 11 mm body ends at 39.97, above the 38.55 split, so the whole keyboard pocket
    is in the face part; kb_ribs() runs the body's full depth instead of stopping at
    the plane, and kb_support() becomes a backstop below the body (same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
    [common.scad, face.scad, ktemata_case.3mf, ktemata_face.stl, ktemata_keyboard_support.stl]
2026-10-24 Enable GDM autologin for a ktemata account
    The device is an appliance, so the post-install now creates a `ktemata` user and turns on
    GDM automatic login for it:
    [daemon]
    AutomaticLoginEnable=true
    AutomaticLogin=ktemata
    - the config name differs by distro: /etc/gdm3/custom.conf on Ubuntu, daemon.conf on
    Debian (checked in the real gdm3 packages), so use whichever exists and only create one
    when GDM is installed without a config
    - edit only the two keys we own; a stock custom.conf carries commented
    "# AutomaticLoginEnable = true" defaults, with spaces, which are replaced in place
    instead of producing duplicates. Other sections and the timed-login defaults are left
    alone; a .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
2026-10-24 Set the logo as the desktop background and boot splash
    Background: docs/ktemata-wallpaper.svg (black 1920x1080, book mark at 18% opacity,
    KTEMATA wordmark, motto), installed to /usr/local/share/ktemata and applied per desktop
    stack: pcmanfm/LXDE-pi on Raspberry Pi OS (desktop-items-0.conf + --set-wallpaper),
    GNOME via gsettings (picture-uri AND picture-uri-dark, else a dark theme keeps its own),
    or feh autostart on minimal X11.
    Boot splash: docs/ktemata-splash.svg rendered at install time to the firmware's required
    format - 24-bit TGA, <=1920x1080, <=224 colours - then installed as /lib/firmware/logo.tga
    with the initramfs hook, and cmdline.txt gains fullscreen_logo=1,
    fullscreen_logo_name=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
2026-10-25 Target the flashed Pi OS image: LightDM autologin, keep the account
    The reference platform is now Raspberry Pi OS (trixie) with user ktemata, password
    ktemata and ssh enabled. Two things were wrong for that:
    1. Pi OS uses LIGHTDM, not GDM. Writing /etc/gdm3/custom.conf there would look
    successful and do nothing. The step now detects the display manager and uses the
    matching mechanism:
    LightDM: autologin-user=ktemata in /etc/lightdm/lightdm.conf [Seat:*]
    GDM: AutomaticLoginEnable/AutomaticLogin in /etc/gdm3/custom.conf
    This is the same edit raspi-config's "B4 Desktop Autologin" makes, so the two agree.
    LightDM wins when both are present. The commented #autologin-u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
2026-10-25 Make the I2C report one line instead of dumping every address
    Reported as clutter on the Pi. The old output listed the bus count and then every
    address on every bus, followed by a repeated per-device PASS line, and hw_ups walked
    all the buses again.
    Now: the scan runs once (cached), addresses are matched against the build's own chips and
    printed as a single line -
    PASS I2C: 0x3c (OLED), 0x42 (UPS INA219), 0x68 (DS3231)
    - anything unrecognised is summarised as "N other address(es) present" rather than listed,
    and the bus count is only mentioned when there is more than the expected pair. hw_ups
    reuses the cached scan.
    The address parser now strips the "40:" row label first and takes ever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
2026-10-25 Ignore I2C adapters that answer for every address
    A real Pi reported 0x3c and 0x3d (one OLED's two strap options) and 0x76 and 0x77 (one
    BME688's) together, plus "82 other address(es)" across 3 buses. That is not a topology:
    one adapter, vc4-hdmi's DDC line, ACKs every address, so its phantom devices were being
    summarised into the report.
    - i2c_scan() drops any bus that answers on 32+ addresses and records it in I2C_BOGUS;
    the report names those buses instead of counting their addresses
    - an impossible strap pair (3c+3d, 76+77) is now a warning that says exactly that
    Also fixes a regression from the previous commit: i2c_label() was deleted while
    hw_i2c_bus() still called it, so the I2C l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
2026-10-25 Optionally disable the CSI camera probe in config.txt
    The build has no camera, so the firmware's camera scan is only boot time. Rather than edit
    config.txt behind the user's back - a bad line there can make the board unbootable - this
    is opt-in via --no-camera-autodetect.
    The edit sets camera_auto_detect=0 and handles the enabled, commented
    ("#camera_auto_detect=1") and absent forms; it never leaves two live lines, keeps
    config.txt.ktemata.bak once, verifies the result by reading it back, and is a no-op when
    already disabled.
    Explicitly left alone, with the reasons recorded in the function: display_auto_detect
    (disabling it stops the DSI display being detected), display_rotate (firmware-le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
2026-10-25 Add arm64 build workflows for a Project NOMAD fork
    Project NOMAD publishes amd64-only images, so docker compose fails on a Pi with "no
    matching manifest for linux/arm64". The images are not the blocker: the admin Dockerfile
    already switches on TARGETARCH and pins PMTILES_SHA256_ARM64, and both sidecars are
    FROM alpine:3.20 + apk packages. Only the CI never asked for arm64.
    work/patches/arm64-workflows/ holds drop-in replacements for three workflows that build
    both platforms on native runners (ubuntu-24.04-arm), push per-digest, and merge into a
    multi-arch manifest in the fork's own namespace. build-translate-proxy.yml is deliberately
    untouched: its Dockerfile states Bergamot's intgemm backe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
2026-10-28 Add r5: internal cassette for a host hard case
    r5 keeps the r4 electronics (Pi 5, Touch Display 2, UPS HAT (B) with 2x18650,
    Rii K06) and drops the air-quality sensor. The printed exterior is replaced by
    three parts that drop into a bought waterproof case, with the display mounted on
    the inside of the lid:
    cad/r5_tray.scad 233.5 x 178.1 x 46.0 floor tray: cell saddles,
    module trays, charge bracket, M2.5 bosses for the deck
    cad/r5_deck.scad 233.5 x 178.1 x 17.2 keyboard pocket + lip, OLED
    through-pocket, 40-pin/FFC keep-out
    cad/r5_lid_plate.scad 155.4 x 103.5 x 2.0 display plate, VHB taped to the lid
    The proposed Peli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
    [assembly_r5.scad, common.scad, export.scad, ktemata_r5_deck.stl, ktemata_r5_lid_plate.stl, ktemata_r5_tray.stl, r5_deck.scad, r5_lid_plate.scad]
2026-10-28 Document the power budget and compare it with Project NOMAD
    docs/POWER.md works out what the r4 build actually draws and what that
    means per day, then sets it against Project NOMAD's recommended x86
    builds with the AI left off, which their FAQ supports.
    Ktemata: 3.5 W screen off, 5.1 W idle with the display on, 6.5 W
    reading, 8.7 W browsing, 12.5 W heavy, at the 5 V rail. Applied to the
    22.2-25.9 Wh 2S pack that is 4.7-1.3 h of runtime; the README's
    "2-2.5 h" is the browsing/heavy case and holds. Duty-cycled 1-4 h/day
    it is 7-40 Wh/day, so the 20-30 W panel has two to three times the
    margin the pack needs.
    NOMAD, measured idle: 11-18 W budget (OptiPlex/ThinkCentre), 7-9 W
    recommended (UM89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
2026-10-28 Rewrite the power page for r5 on a 24/7 basis with all three NOMAD tiers
    The page compared r4, scored Ktemata on a handheld duty cycle and a
    NOMAD box on 24/7, and only covered the budget and recommended tiers.
    Both machines are now scored over the same 24 hours, r5 is the subject
    (same electronics as r4, no air-quality sensor), and the power tier is
    included.
    Ktemata r5 gets three unflattering duty profiles rather than a best
    case: screen off 24 h (109 Wh/day), 4 h reading in a day (120 Wh/day)
    and kiosk with the display lit throughout (139 Wh/day). NOMAD is
    headless, so its whole day is idle or loaded: 348 Wh/day budget,
    192 recommended, 840 power.
    On identical duty r5 uses 1.6-7x less e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
2026-10-28 Add a pros/cons comparison with the Prepper Disk
    docs/COMPARISON-PREPPERDISK.md sets the r5 build against the
    commercial Prepper Disk Premium (Pi 4B 2 GB, 512 GB microSD, 20
    devices over its own Wi-Fi, EUR 271 with a one-year warranty).
    The honest split: the Prepper Disk is the better product. It is 2.3x
    cheaper, 53x smaller by volume, ~8x lighter, draws 3.05 W against
    4.0-5.1 W, serves 20 devices instead of one, arrives configured, and
    ships licensed content that updates. Ktemata wins on being usable with
    no other device in the room, on carrying its own 22.2 Wh pack (the
    Prepper Disk ships without a battery), on upgradeable NVMe storage
    instead of a microSD, on field repairability from sto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
2026-10-28 Note that the hotspot difference is policy, not hardware
    The comparison implied Ktemata cannot serve a room. It can: the Pi 5
    carries the same dual-band 2.4/5 GHz Wi-Fi radio as the Prepper Disk's
    Pi 4B, and r5 only disables it in config.txt (dtoverlay=disable-wifi)
    because this project's brief is an offline device with no networking.
    hostapd + dnsmasq turns it into an access point in one configuration
    change, serving the same ZIM files to the same browsers.
    Scores that mode instead of asserting it: an estimated 0.4 W for the
    access point takes r5 to 4.4 W and 220 mW per connected device against
    the Prepper Disk's 152 mW - the same league, with r5 keeping its own
    screen and battery. The com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
2026-10-28 Add EMP shielding to the Prepper Disk comparison
    Records the r6 direction (a conductive lining and a gasketed seam in
    the Peli 1200) as an assessment rather than a feature, and scores it
    against what the Prepper Disk actually sells: a EUR 22 Faraday Defense
    NX3 bag, 127 x 178 mm, 85-90 dB claimed, into which its 89 x 70 x 25 mm
    board fits with room to spare.
    The useful result is quantitative. Shielding effectiveness is set by the
    largest aperture, and a moulded case ships with an 835 mm one: by the
    worst-case slot-antenna estimate the stock lid/base seam is -14.9 dB at
    1 GHz, so painting the interior without gasketing the seam achieves
    nothing. With a conductive gasket in the existing O-rin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
2026-10-28 Ship the library hotspot as a post-install option
    The Pi 5's dual-band radio is on board, so serving the ZIM library to a
    room costs about 0.4 W (estimated) and no hardware. `post-install.sh
    --hotspot` now builds it: the same function the commercial Prepper Disk
    ships with, which the comparison had scored as a policy difference only.
    Implementation, in order of preference:
    - NetworkManager (Pi OS Bookworm+, Ubuntu desktop): one self-contained
    nmcli profile, 802-11-wireless.mode ap + ipv4.method shared, so DHCP
    and DNS come from NM's own dnsmasq and nothing else is installed.
    - otherwise hostapd + dnsmasq: hostapd.conf at 0600, a dnsmasq drop-in
    that answers every name with t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
2026-10-29 add to site (power and comparisons)
2026-10-29 minor changes
    [ktemata_r5_cass.3mf]
2026-10-29 Add licensing: MIT firmware/tooling, CC BY-SA 4.0 design
    There was no LICENSE in the repository, only an "MIT-style" remark in the
    Prepper Disk comparison and a "free to reuse" line in the site footer.
    - LICENSE: MIT for firmware/, cad/tools/, work/scripts/ and site/style.css
    - LICENSE-CONTENT: CC BY-SA 4.0 for the OpenSCAD geometry, docs, renders,
    STLs and site prose/images, with the scope and the exclusions spelled out
    (build guide, reference/ derivatives, ZIM content, runtime software, marks)
    - site/license.html: scope table, why the split, attribution template, links
    to both texts, what is not covered, no-warranty note
    - Licence added to the nav on every page, and the footers now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
2026-10-29 post-install: --no-radio, a real firmware off switch for the radios
    --no-hotspot only declines to create an access point. The radio stays
    enabled, wlan0 still associates with a saved network, and kiwix-serve runs
    without --address so it binds 0.0.0.0:8080 on every interface that comes up.
    That makes "turn the hotspot off and you are unfindable" false, and the site
    said exactly that.
    --no-radio disables the on-board Wi-Fi and Bluetooth in config.txt:
    Pi 5 / 500 / CM5 dtoverlay=disable-wifi-pi5, dtoverlay=disable-bt-pi5
    Pi 4 and earlier dtoverlay=disable-wifi, dtoverlay=disable-bt
    The SoC comes from /proc/device-tree/compatible, falling back to the Model
    line in /proc/cpuinfo. Th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
2026-10-29 add 3mf
    [ktemata_r5_cass.3mf]
2026-10-30 r5: lid cover with a display bezel and a power button
    The cassette filled the base of the Peli 1200; this is the lid. r5_lid_plate
    was a flat 2 mm plate that only held the panel. r5_lid_cover lines the whole
    lid interior (233.5 x 178.1, the same 1.5 mm clearance the tray uses), forms a
    7 mm bezel around the Touch Display 2 and puts a 16 mm IP67 metal power button
    in the band at the latch end.
    The stack is the TD2's own and is shared with the rest of r5: 4 mm plate, the
    display's 8.5 mm standoffs, 6.42 mm of panel body, glass, and the bezel rising
    1.5 mm past the glass to protect its edge. 20.42 mm of the 30.2 mm lid, which
    leaves 9.8 mm for the cable fold. Glass ends up 85.68 mm above the h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
    [assembly_r5.scad, common.scad, export.scad, ktemata_r5_lid_cover.stl, r5_lid_cover.scad]
2026-10-30 logo: the case open from above, instead of a closed handheld
    The mark showed a closed front view: it read as a generic tablet and never
    said where the keyboard and the screen sit. It is now the case seen from
    above, opened 180 degrees, so the two halves lie side by side and the layout
    is legible at a glance:
    top half the lid, with the display and the open-book screen
    bottom half the base, with the K06 keyboard (accent key = trackpad corner)
    between three hinge barrels on the joint
    front edge the two latch catches
    Proportions follow the real Peli 1200 rather than a squarish box: the lid
    interior is 236.5 x 181.1 mm (1.31:1), each half is that wide, and the grip
    ribs sit on b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
2026-10-30 logo: clear the case off the inner frame line
    The top of the case sat exactly on the orange inner frame (0 mm gap) while the
    bottom had 14 mm, so the art looked like it was spilling out of the plaque at
    the top and floating at the bottom.
    The case art is now translated 14 units down and the wordmark/subtitle move
    with it, leaving 14 mm above and 12 mm below - visually even against the
    16 px frame. site/logo.svg and docs/ktemata-logo.svg stay byte-identical.
2026-10-30 r5 deck: fan opening instead of the slot bank, OLED centred
    The old cooling was five 2.4 mm slots at the right-hand end (x 150-208,
    y 101-108.4). They were in the wrong place: the keyboard pocket's hinge wall
    occupies y 100.7-102.5, so the slots cut into the pocket rather than venting
    anything - the part that holds the keyboard was partly over them, as reported.
    A slot bank also moves little air.
    Removed, and replaced by a round opening for a 40 mm fan in the free top-left
    corner, centre (44, 38), clear of the keyboard (pocket starts at y = 102.5) and
    of the deck screws (nearest 38.95 mm). DECK_FANS=1 is the default; DECK_FANS=2
    adds the same opening at (189.5, 38) in the top-right corner.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
    [common.scad, ktemata_r5_deck.stl, r5_deck.scad]
2026-10-30 r5 deck: sink the keyboard so the keys sit level with the plate
    The K06 body is 11 mm and the deck plate is 3 mm, so the pocket left the
    keyboard standing 11 mm proud. It now drops into a well that hangs 8 mm below
    the plate, rests on a 1.2 mm floor, and the keys finish at z 48.95 - the
    deck's own top face, 0.0 mm proud (was 11).
    Consequences, both deliberate:
    - the deck must be printed TOP FACE DOWN. The well hangs below the plate, so
    printed plate-down it would be a floating island; flipped, every well wall is
    vertical and nothing overhangs. Recorded in the deck header and docs/R5.md.
    - the fan grille is now recessed flush instead of standing 1.2 mm proud, since
    anything above the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
    [common.scad, ktemata_r5_deck.stl, r5_deck.scad]
2026-10-30 r5 deck: remove the dead right-wall opening
    The 12 mm opening at x 214.9-231.9, y 60-100 was commented as "DS3231 and
    charger module leads", but nothing it was cut for crosses the deck:
    DS3231 y 26-52 overlap 0 mm
    MPPT charger y 62-86 overlap 3.1 mm of its pad's outer edge
    charge socket y 107-129 overlap 0 mm
    All three sit below the deck - the lowest at z 2.4, the deck underside at
    45.95 - so their leads stay in the tray cavity and never reach the plate.
    The hole's only real overlap with anything was a 3.1 x 24 mm sliver of the
    MPPT pad edge.
    It also overshot the wall (x to R5_W - R5_WALL + 1), so it opened the deck's
    edge outward: 12 mm of lost stiffne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
    [ktemata_r5_deck.stl, r5_deck.scad]
2026-10-30 minor changes to STLs
    [ktemata_r5_cass.3mf]
2026-10-31 r5: mount the boards side by side on the floor, bolt both down
    r5 stacked the Pi on the HAT (B) with pogo pins, so the whole assembly hung
    off the cell cradles and nothing was screwed down. Power is now soldered
    from the HAT to the Pi, which lets the two boards be independent, and they
    sit side by side on the tray floor: the UPS HAT (B) at x 76-132 and the
    Pi 5 + Seeed M.2 BASE + SSD at x 152-208, both portrait (85 along y) and
    both held by four Ø8 posts (Ø2.2 pilot, M2.5).
    Positions come from reference/first_fit.jpg, measured through a homography
    fitted to the tray's own outline. Both boards carry the 58 x 49 Pi-standard
    hole pattern, which is what lets one post design serve both; the po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
    [assembly_r5.scad, common.scad, ktemata_r5_cass.3mf, ktemata_r5_deck.stl, ktemata_r5_tray.stl, r5_deck.scad, r5_tray.scad]
2026-10-31 r5 deck: 4.5 mm plate, two fans, open keyboard recess
    Four changes to r5_deck, from a first print that was too wobbly and too
    support-hungry.
    1. The plate is 4.5 mm instead of 3, and the extra 1.5 mm goes on the TOP
    face: the underside stays at R5_DECK_Z, so the keyboard recess, the Pi
    keep-out and every pocket keep their own depths. A 3 mm plate spanning a
    151 x 59 mm opening was the wobble.
    2. DECK_FANS now defaults to 2, so both top corners get a 38 mm fan opening
    with its flush seven-bar grille (centres (44, 38) and (189.5, 38)).
    3. The FireBeetle access hole moves from 30 mm to 44 mm along its module
    (R5_FB_HOLE_Y0). At 30 it abutted the left fan opening, which read as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
    [common.scad, ktemata_r5_cass.3mf, ktemata_r5_deck.stl, r5_deck.scad]
2026-10-31 r5 deck: delete the 40-pin header clearance slot
    The 12 x 81 mm slot over the Pi's GPIO edge was a leftover from the design
    where the deck clamped the Pi down on four pillars; those pillars would have
    landed on the 40-pin header, which sits 3.5 mm in from the GPIO edge and
    directly over the mounting holes. The slot existed so a pillar could pass
    around the header.
    Nothing clamps the Pi any more - it bolts to the tray floor - so the deck is
    a lid 10.3 mm above the header and the slot shielded nothing. It gave up
    4.4 cm3 (2.3 %) of plate for no purpose, and it abutted the hinge-edge
    opening by 2 mm, turning that opening into a 150 x 99 L-shape.
    Removed the module and its call. The invariant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
    [common.scad, ktemata_r5_cass.3mf, ktemata_r5_deck.stl, r5_deck.scad]
2026-10-31 build guide: placeholder page and README section
    Adds site/build.html, a placeholder for the step-by-step build record, plus
    a Build entry in the nav of every page and in the landing page's Explore
    list, and a Build guide section in README.md.
    The page carries the fixed running order (parts check, print the cassette,
    bolt the boards down, solder the power run, fit the cells and modules, glue
    the keyboard, mount the display, route the FFC, close and check, first boot)
    and says plainly that the photographs and clips are still to be shot. Photos
    go per step when they exist, in the same <figure> style the Power page uses.
    No build changes: site/build.sh leaves hand-written pages alone and
    site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
2026-11-01 BOM: move to docs/ and reduce to a plain parts list
    Move BOM.md to docs/BOM.md and strip it down to parts, quantities,
    specs and indicative prices: no order reconciliation, purchase status,
    shop links or subtotals. The environment sensor (BME688, its membrane
    vent, and the SEN66 alternative) moves to the nice-to-have section with
    a note that r5 has no sensor pocket.
    The r5 Peli case joins the parts list, so the cited build cost changes
    too: parts ~EUR 461, ~EUR 580 complete. Propagate that to the Prepper
    Disk comparison, site/comparisons.html and power_chart.py, and fix the
    BOM.md -> docs/BOM.md references in README, LICENSE-CONTENT, POWER,
    WIRING, SLIMMING and POCKETTERM35-FEASIBILITY.
2026-11-01 r5 deck: size the OLED cut to the glass, one fan, opening clear of screws
    The OLED cut was the pcb outline: one 35.8 x 34.8 hole through the 4.5 mm
    plate, so the board's edge showed all round a 1.3" panel. The module is now
    modelled from its measurements - pcb 35.5 x 33.7 x 1.2, glass 34.5 x 23 x 1.45,
    lit area 29.42 x 14.7 - and the deck carries two cuts instead: a 34.8 x 23.3
    window through the top face over the glass, and a 36.3 x 34.5 pocket sunk
    1.2 mm into the underside for the pcb. The pcb drops in from below and stops
    on the pocket ceiling, flush with the deck's underside so its back can be
    taped; the plate ring between the cuts is the bezel and hides the board, and
    the glass finishe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
    [assembly_r5.scad, common.scad, export.scad, ktemata_r5_cass.3mf, ktemata_r5_deck.stl, ktemata_r5_lid_cover.stl, ktemata_r5_lid_plate.stl, ktemata_r5_tray.stl]
2026-11-01 site: Alexandria page — the ZIM book collection, and my curated shelf
    New page site/alexandria.html for Project Alexandria, the separate tool
    (github.com/jsoeterbroek/alexandria) that turns Project Gutenberg ebooks into
    searchable ZIM archives, and the shelf it has actually built.
    The page is explicit that the selection is personal: it is not a reading list
    or a canon for anyone else. The lede, a note block and the footer all say so,
    and the framing is why the name fits - Alexandria was famous for being chosen,
    not for holding every scroll, and a full Gutenberg download would be a
    warehouse rather than a shelf.
    Every figure comes from the project itself, not from estimates: 128 books,
    4,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
2026-11-02 cad role added
2026-11-02 r5: seven M3 deck screws, keyboard sunk onto seat ledges; centre the OLED window
    Rebuilt after the working tree was lost mid-session; this carries both this
    change and the OLED/keyboard work that was committed before the loss.
    Deck screws: six M2.5 into self-tapping pilots becomes SEVEN M3 into heat-set
    inserts. The deck comes off for every service - keyboard, OLED, fan,
    FireBeetle - and a 2.2 mm pilot in PETG strips long before an insert does. So
    the boss grows Ø7 -> Ø9 with a Ø4.2 x 6 mm insert bore; the remaining 2.4 mm of
    wall is what an M3 insert (4.6 mm OD) needs. The inset stays 2.5 mm rather than
    R5_BOSS_D/2 - 1: at 3.5 the left-wall bosses reach x 10.6 and eat 0.6 mm into
    the Fi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
    [assembly_r5.scad, common.scad, ktemata_r5_deck.stl, ktemata_r5_tray.stl, r5_deck.scad, r5_tray.scad]
2026-11-02 updated for new stl files
    [ktemata_r5_cass.3mf]
2026-11-02 r5: three airbrush paint schemes for the deck and lid cover
    The two painted faces of the r5 build are the deck (keyboard side) and the
    lid cover (bezel round the Touch Display 2). Add cad/tools/paint.py, which
    generates three designs as 1:1 mm SVG plus PNG previews:
    MERIDIAN a chart graticule ruled from the hinge, 17.81 mm pitch
    STRATA five bands up both rails, keyed to x, straight across the seam
    BEARING a slate border and one amber trace through the seam
    Every dimension comes out of the model through cad/tools/paint_probe.scad ->
    common.scad, so the sheets cannot drift from the part: the apertures drawn
    on them are the real ones and the sheets double as masking templates.
    La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
    [paint_probe.scad]
2026-11-02 r5 paint: Meridian chosen, plus one mask cut file per paint pass
    Meridian is the design to build. Recording that decision is the small part;
    the rest is making it paintable rather than just visible.
    --stencils now writes a cut file per paint pass (ash, amber, seam, bezel),
    one per colour, because each colour is a separate masking: spray, lift,
    re-mask. Black is the sheet you lay on the part, white is what the blade
    removes, and the part outline is the datum, so a mask lands without
    measuring. Registration crosses in the margin align the passes.
    The colour sheet and the cut files are driven by one description of the
    scheme - meridian_marks() returns Mark objects - so they cannot disagree.
    T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
2026-11-02 r5 paint: deck tagline is OFFLINE LIBRARY
    Replaces the "OFF GRID - ON RECORD" tagline on Meridian (the chosen scheme)
    and on Bearing, which carried the same phrase. Strata keeps its own.
    The line is shorter than the wordmark above it (54.7 mm against 85.9 mm at the
    same tracking), so the reserved type block in Model.type_boxes is unchanged and
    the graticule still stops cleanly round it.
2026-11-03 r5 paint: Meridian type blocks as print-ready stickers
    The deck wordmark and the lid motto were stencilled, which is the one part of
    Meridian a hand-cut mask cannot do: the tagline is a 0.35 mm stroke, below what
    a blade holds cleanly, and a slipped stencil cannot be repaired invisibly.
    `paint.py --stickers` now writes both blocks as vinyl instead. Each is a filled
    graphite plate 2.5 mm larger than the ink, with 1 mm of bleed and no cut line -
    123sticker rejects artwork carrying one - so the die-cut contour is a rectangle
    they add. Lettering is the same _text_path() outlines that draw the sheets, so
    the sticker is the design and not a lookalike.
    Model.type_boxes is now derived from sticker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
2026-11-03 gitignore: ignore PDFs by default, keep the deliverables
    "do not include pdf's" only covered site/pdf/*.pdf, so any other PDF was
    tracked by default - including a stray one dropped into docs/.
    Invert it: *.pdf is ignored, and the files a reader needs from a clean clone
    are explicit exceptions - the r3 wiring diagram and the two sticker upload
    files that paint.py --stickers writes. The exceptions are a safety net rather
    than a fix for live breakage: a tracked PDF is never dropped by ignore rules,
    so the deliverables were already safe; this stops a future broad rule from
    sweeping them away without anyone noticing.
    reference/bst-bme688-ds000.pdf stays tracked: the exception list is for
    delive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
2026-11-03 r5: hang the 7" Touch Display 2, centred, and move the power button to the deck
    The lid was modelled for the 5" TD2 (143.4 x 91.46, standoffs 122.74 x 72.96);
    the 7" in docs/BOM.md was only a label change, with the 5" numbers beside it.
    r5 now uses Raspberry Pi's 7" brief (RP-010429): module 189.32 x 120.24 with R8
    corners, active area 154.6 x 86.9, standoffs on 168.55 x 99.71. The depth is the
    same 14.92 mm (8.5 standoffs + 6.42 body), so the vertical stack, the lid
    assertion and the 2 mm plate are unchanged and only the plan grew.
    The panel runs landscape because it has to: 189.32 mm is longer than the
    cassette's 178.1 mm length, so portrait cannot fit any accepted host. It is
    centred in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
    [assembly_r5.scad, common.scad, ktemata_r5_cass.3mf, ktemata_r5_deck.stl, ktemata_r5_lid_cover.stl, ktemata_r5_lid_plate.stl, paint_probe.scad, r5_deck.scad]
2026-11-04 paint: printable stencil masks, and fix two 7" cover errors they exposed
    stencil_stl.py writes the Meridian masks as rigid 1.2 mm panels - amber, seam and
    bezel for both parts - so the passes can be sprayed from a printed part instead
    of cut vinyl. The SVG sheets are 261.5 x 234.1 mm (part + a 14 mm handling
    margin) and do not fit a 256 mm bed; the STLs are the part outline alone,
    233.5 x 178.1, and land on it with their own outline as the datum.
    The geometry comes from paint.py's mark and aperture data, not from rasterising
    the SVG: a round trip through pixels would quantise the 0.5 mm graticule slot,
    which is the one dimension that has to survive. Both outputs read the same
    objects, so th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
    [stencil_cover_amber.stl, stencil_cover_bezel.stl, stencil_cover_seam.stl, stencil_deck_amber.stl, stencil_deck_seam.stl]
2026-11-05 r5: fill the host mouth with the deck, wider OLED cuts, charge socket on the deck
    - deck sized to the host cavity at its own height (243.3 x 186.8 for the Peli 1200,
    from the published 236.5 x 181.1 floor section and the measured 250 x 193 mouth)
    instead of the cassette's 233.5 x 178.1; every screw and cut keeps its absolute
    position, the hinge opening starts at the new plate edge, corners R18.4
    - OLED: window and pocket +1 mm a side (36.8 x 25.3 / 38.3 x 36.5); the 4.2 mm end
    strips carry the module and the guards now check that it cannot drop through
    - charge socket: 5.5 x 2.1 DC jack through the deck's right rail at (216, 90), so
    the host is never drilled; tray bracket and wall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
    [assembly_r5.scad, common.scad, ktemata_r5_deck.stl, ktemata_r5_tray.stl, paint_probe.scad, r5_deck.scad, r5_tray.scad, stencil_deck_amber.stl]
2026-11-05 r5 deck: countersunk screw seats and a flush fan grille
    The deck is printed top-face down, so its downward faces over voids were
    what the slicer flagged as unsupported: the seven Ø6.2 counterbore
    ceilings (flat bridges inside 1.8 mm wells) and the seven grille bars
    0.5 mm above the bed over the Ø38 fan opening.
    - screw seats: 90 deg countersink for M3 x 10 countersunk (DIN 7991 /
    ISO 10642) instead of a counterbore; a 45 deg cone needs no support
    (Bambu supports surfaces flatter than 30 deg from the horizontal)
    - fan grille: bars start on the bed, flush with the top face, so the
    38 mm bridge is gone and the face is flat as documented
    - BOM and R5.md: countersunk deck screws; the ins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
    [common.scad, ktemata_r5_cass.3mf, ktemata_r5_deck.stl, r5_deck.scad]
2026-11-06 docs: r5 deck screws are countersunk M3 x 10 (DIN 7991 / ISO 10642)
    The deck's seats are 90 deg countersinks, so button heads no longer seat.
    Noted in AGENTS.md, README, docs/R5.md (parts + verify) and the deck source
    header; the BOM part was already updated with the countersunk screws.
    [r5_deck.scad]
2026-11-06 status oled: Pi-side sender for time and storage
    status-oled.py pushes UTC hourly (and on the board's boot banner) and the
    library free space every 60 s over the USB serial link, autodetecting the
    FireBeetle's CH340 and retrying across unplugs. post-install.sh installs it
    as ktemata-status-oled.service, with --no-oled / --oled-port, and the
    hardware report now names the serial device when present.
2026-11-06 status oled: survive the CH340 reset and keep the serial stream JSON
    Opening the port resets the ESP32, so the first command was truncated ("bad
    json"). The sender now waits 2 s before writing, repeats time until the board
    logs "time synced", and resends both after a rejected command. Non-JSON lines
    (boot ROM) are ignored unless -v, so they no longer land in the journal.
    The firmware compiled its core logger in (CORE_DEBUG_LEVEL=1), so Wire.cpp I2C
    errors for the absent BME688/UPS arrived as free text; compile it out and set
    the ESP-IDF level to NONE. The build still succeeds for the DFR1140.
    [main.cpp]
2026-11-06 firmware: use Roboto for the OLED UI
    Replace the blocky built-in 5x7 font with Roboto: a 5 pt body font and an
    18 pt clock, generated as Adafruit_GFX bitmap headers from the Roboto
    variable font (google/fonts, OFL 1.1; license included). The body keeps the
    10 px row pitch and tabular digits, so the existing five-line screens and
    the padded columns still fit; the clock is 84 px wide and centred.
    Custom GFX fonts draw from the baseline, so bodyCursor/bodyCentered/
    clockCentered take the top of the line and add the font ascent (7 px body,
    24 px clock). Layout is unchanged except the time screen, where the date
    moves up under the larger clock.
    [main.cpp]
2026-11-06 post-install: add --library nomad and skip the host Kiwix stack
    NOMAD's admin publishes :8080, the same port as the host kiwix-serve, and its
    Kiwix service (ghcr.io/kiwix/kiwix-serve, host :8090) serves
    $NOMAD_STORAGE_PATH/zim instead of /srv/kiwix/zim. The two front ends cannot
    share the device as configured.
    --library nomad skips the Kiwix packages, desktop app, /srv/kiwix/zim, user,
    service and --sample, and makes the hardware check and the status OLED sender
    use $NOMAD_STORAGE_PATH/zim. The default stays host. Verify reports the NOMAD
    container state instead of probing kiwix-serve, and an existing NOMAD compose
    file triggers a warning when the host library is selected.
    Checked against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
2026-11-06 status oled: lock the serial port against a second sender
    Two processes reading one tty split the incoming bytes, so a manual run beside
    ktemata-status-oled.service can miss the board's "time synced" reply and report
    that the clock was never confirmed while the service sees it. Take an exclusive
    flock on the device and fail the second opener with "another sender is using ...".
    Log "clock synced" once when the acknowledgement arrives, and document stopping
    the unit before manual runs.
2026-11-06 firmware: report a full 2S pack as 100 %, not 99/100
    The linear 6.0-8.4 V model is not accurate to 1 % at the top, and one INA219
    LSB (4 mV) is enough to cross the 99.5 % rounding boundary while the pack sits
    at 8.4 V, so the OLED flickered between 99 % and 100 %. Snap >=99 % to full;
    the charge state and the CHG flag already key off 99 %. Verified against the
    official Waveshare INA219 script (8.404 V, 100 %).
    [ups_hat_b.cpp]
2026-11-06 firmware: space out the date and add clock/battery icons
    The date line was "Wed 06 Nov 2026" in a proportional font; drop the leading
    zero on the day and put three spaces around the weekday and month blocks.
    Draw a 9x9 clock icon beside the date and an 11x7 battery icon beside the
    battery line, with the fill following the pack percentage. Both are vector
    primitives, so no extra font or bitmap is needed; the icon + text group is
    centred as one unit.
2026-11-06 firmware: show external power with a plug icon
    The INA219 sits on the pack branch, so the current sign is the reliable
    mains test: below -10 mA the pack is supplying the load (battery only);
    otherwise the charger is attached, including the near-zero current of a full
    pack where the charger feeds the load. Derive UpsStatus::mains from that and
    keep vbusPresent as its telemetry alias.
    Draw a 6x7 plug after the battery line whenever mains is present; CHG still
    marks active charging, so a full pack on charge reads BAT 100% + plug. The
    battery screen now says on battery / charging / on mains and shows pack
    voltage. Drop the unused chargeState/chargeStateName.
2026-11-06 firmware: fix the compiler warnings
    - print flash/PSRAM as %lu with explicit unsigned long casts (uint32_t is
    long unsigned on the ESP32)
    - keep the build timestamp as a uint32_t epoch and construct the DateTime in
    currentTime(); assigning a DateTime hits RTClib's deprecated implicit copy
    assignment
    - compile the idle-blanking block only when SCREEN_OFF_MS > 0, so the
    unsigned >= 0 comparison disappears in the current 0 ms build
    Both the 0UL and 60000UL builds compile without warnings.
    [main.cpp]
2026-11-06 firmware: add NUT-style OL/OB/LB flags and load percentage
    Battery screen: OL/OB, an LB flag below 10 %, and load N% of the HAT's
    5 V / 5 A (25 W) output; the state line below it says discharging, charging
    or full. Telemetry gains ol, ob, lb, status ("OB LB") and load_pct.
    The load is only measurable while the pack supplies it: the INA219 is on the
    pack branch, so on mains the charger feeds the regulator and the gauge sees
    the charge current instead. load_pct is null (and the screen shows --) on
    mains; a second shunt on the 5 V rail would be needed for a mains load.
    Load assumes 88 % buck efficiency and clamps at 100 %.
2026-11-06 firmware: report battery.runtime from the measured load
    Serialise runtime_s (NUT battery.runtime, seconds) from the measured discharge
    current and the voltage-derived remaining capacity; the battery screen shows
    ~XhYYm / ~Ym / ~Ys left, or "runtime --" when it is not valid. Runtime is only
    computed while the pack is discharging (on mains the gauge sees charge current)
    and above 20 mA.
    Drop the old discharge_min field and the unused pack/2 "cell" estimate; clamp
    charge_min so a very small charge current cannot wrap the uint16 minutes.
2026-11-06 firmware: auto-cycle the screens every 25 s until the button is fitted
    Add AUTO_CYCLE_MS (0 disables). The build sets 25000UL: the four screens advance
    time -> battery -> environment -> storage, so the UPS statistics are visible
    without the PBS-33B. An active alert still takes over, and a wake (button,
    serial screen command, alert) restarts the 25 s. The 30 s return-to-time block
    is compiled out while cycling. Set AUTO_CYCLE_MS=0UL with the button.
2026-11-06 firmware: remove the BME688 and the environment screen
    The sensor is no longer part of the project. Drop the BME68x library, driver,
    forced-mode state machine, pressure history, environment alerts and telemetry,
    and the ENVIRONMENT screen: the OLED now cycles time -> battery -> storage.
    Screen indices are 0/1/2; the alerts array is [battery, storage].
    Also shorten the storage header from "STORAGE (from Pi)" to "STORAGE".
    Docs and AGENTS updated; the unused r2/r3/r4 sensor pocket stays in the CAD.
    [config.h, main.cpp]
2026-11-07 post-install: enable the Pi RTC trickle charge for the ML-2020
    The Pi 5's RTC cell is a rechargeable ML-2020 on J5; without
    dtparam=rtc_bbat_vchg=3000000 the PMIC never tops it up. Add an idempotent
    config.txt step (commented/different/absent forms, one live line, backup once)
    and a --no-rtc-charge opt-out because a non-rechargeable CR2032 must never be
    trickle-charged.
    Tested against synthetic configs: replace, rewrite, append, already-set and dry
    run.
2026-11-07 status oled: handle the two-entry alerts array
    The firmware dropped the environment alert, so telemetry alerts is now
    [battery, storage]; the sender indexed alerts[2] and crashed on the first
    telemetry. Name the entries by length (2 now, 3 on older builds) and fall back
    to generic names for anything else.
2026-11-07 firmware: omit load and runtime when they are not measurable
    On mains the charger feeds the regulator, so the INA219 has no load current
    and the runtime is not valid: the battery screen now shows just OL (plus LB)
    and full/charging, with the runtime row blank or "to full" while charging.
    The invalid "load --" / "runtime --" text is gone; on battery the rows are
    unchanged (OB load N%, discharging, ~XhYYm left).
2026-11-07 oled: rename the power screen, add a wifi screen
    - POWER replaces the BATTERY header; its rows are packed from the top, so the
    OL flag and the load row disappear on mains instead of leaving a gap, and
    the state line reads discharging / charging / battery full.
    - New WIFI screen shows off, on (client) or on (AP mode) plus the age of the
    report. The FireBeetle has no radio: status-oled.py reads the Pi's own state
    (nmcli mode of the active wlan0 profile, else hostapd, else iw) and sends
    {"cmd":"wifi","state":...} every 15 s, which also lands in the
    telemetry as wifi.state/age_s.
    - Screen count is now SCREEN_COUNT (4): the button cycle and the serial
    screen command both follow it.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
    [main.cpp]
2026-11-07 r5: retarget the lid to the Waveshare 7inch DSI LCD (C)
    Panel: 192.96 x 110.76, active 154.88 x 86.72 (top 11.00 / bottom 13.04),
    10.50 mm front glass to PCB back, four M3 rear inserts (asymmetric 126.25 x
    65.49 span) and unused 58 x 49 M2.5 Pi standoffs 3.5 mm behind the PCB. All
    numbers are from the Waveshare drawing and STEP.
    Cover/plate: 4 mm plate, M3 screws through into the rear inserts with the heads
    counterbored on the tape face, blind 3.5 mm reliefs for the M2.5 standoffs, a
    46 mm DSI notch at the hinge, and the bezel top at the glass plane so the
    screen is flush. Cover 233.5 x 178.1 x 14.5; plate 205 x 122.8 x 4. Assembly,
    export and check_r5 updated; bad edges 0.
    Docs/BOM: Waves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
    [assembly_r5.scad, common.scad, ktemata_r5_lid_cover.stl, ktemata_r5_lid_plate.stl, paint_probe.scad, r5_lid_cover.scad, r5_lid_plate.scad, stencil_cover_amber.stl]
2026-11-07 oled: say "station mode" and keep the wifi report alive
    The firmware's WIFI screen said "on (client)"; make it "station mode" and
    "access point". The Pi sender already reports the state, but an old installed
    copy had no wifi command: the current script sends {"cmd":"wifi","state":...}
    at start and every 15 s. Add a last-resort operstate check so a station-mode
    interface is reported as client even without nmcli/iw, and install iw with the
    OLED step.
2026-11-07 oled: hold the time screen twice as long in the auto-cycle
    AUTO_CYCLE_MS is now the dwell on power/storage/wifi (30 s in the current
    build); AUTO_CYCLE_MAIN_MS defaults to twice that, so the time screen stays
    60 s. Wake/alert/button still restart the current screen's dwell. Setting
    AUTO_CYCLE_MS=0 restores the 30 s return-to-time behaviour.
2026-11-07 post-install: drop the dead NOMAD image step
    prepare_nomad_images could not work in any supported flow: it rewrote
    compose only when the refs were ghcr.io/crosstalk-solutions, this fork
    writes eglische/ or project-nomad-local; it never ran compose up, so a
    rewrite left the old containers running; and on arm64 the NOMAD installer
    builds the three images locally instead of pulling them.
    Remove the step, its three flags and defaults. --library nomad is
    unchanged; docs now say NOMAD is installed by its own installer first
    (and that the fork's installer needs [pi5] kernel=kernel8.img).
2026-11-08 Recess r5 display and align cable routing
    [assembly_r5.scad, common.scad, export.scad, ktemata_r5_cass.3mf, ktemata_r5_lid_cover.stl, ktemata_r5_lid_plate.stl, paint_probe.scad, r5_lid_cover.scad]
2026-11-08 Specify DIN 7991 screws and lid countersinks
    [common.scad, ktemata_r5_cass.3mf, ktemata_r5_lid_cover.stl, ktemata_r5_lid_plate.stl, r5_lid_cover.scad, r5_lid_plate.scad]
2026-11-08 Remove lid finger slots and switch paint to Strata
    [ktemata_r5_lid_cover.stl, paint_probe.scad, r5_lid_cover.scad, stencil_cover_amber.stl, stencil_cover_ash.stl, stencil_cover_bezel.stl, stencil_cover_deep_amber.stl, stencil_cover_hairline.stl]
2026-11-08 reload stl files
    [ktemata_r5_cass.3mf]
2026-11-08 Remove r5 FireBeetle deck access opening
    [common.scad, ktemata_r5_deck.stl, paint_probe.scad, r5_deck.scad, stencil_cover_amber.stl, stencil_cover_ash.stl, stencil_cover_deep_amber.stl, stencil_cover_hairline.stl]
2026-11-08 Organize r5 and stencil STL outputs
    [export.scad, ktemata_r5_deck.stl, stencil_cover_amber.stl, stencil_cover_ash.stl, stencil_cover_deep_amber.stl, stencil_cover_hairline.stl, stencil_cover_ink.stl, stencil_cover_slate.stl]
2026-11-09 Update r5 lid fit and organize generated files
    [common.scad, export.scad, ktemata_charge_plug.stl, ktemata_r5_cass.3mf, ktemata_r5_lid_cover.stl, ktemata_r5_lid_cover_test_dimensions.stl, ktemata_r5_lid_plate.stl, r5_lid_cover.scad]
2026-11-09 Add r5 website showcase render
    [r5_showcase.scad]
2026-11-09 Refine r5 website showcase
    [r5_showcase.scad]
2026-11-10 r5 lid cover: second fit-check corrections
    Fit check against the printed cover (recess side up, hinge at the bottom)
    gave three corrections, all in the cover and its dimension template:
    * M3 insert pattern another 5 mm towards the latch/top (y 26.58/92.07 ->
    31.58/97.07, panel coords). The earlier correction moved all eight
    positions 5 mm; the screws still missed, so the inserts now sit 7.4 mm
    out of step with the M2.5 standoff reliefs, which keep the first
    correction. R5_DISP_HOLES is the display's own pattern, so
    r5_lid_plate follows.
    * FFC fold pocket: 36 x 33 mm, R3, panel-relative x 132..168 / y 41..74,
    cut from the recess side to a 1 mm floor (3 mm deep). The 4 mm seat
    s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
    [common.scad, export.scad, ktemata_r5_lid_cover.stl, ktemata_r5_lid_cover_test_dimensions.stl, ktemata_r5_lid_plate.stl, r5_lid_cover.scad, stencil_cover_amber.stl, stencil_cover_ash.stl]
2026-11-10 r5 lid cover: back to the 5" Touch Display 2; 7" kept as its own part
    The shipped lid part carries the Raspberry Pi Touch Display 2, 5" again -
    the panel r4 hangs - and the 7" Waveshare cover is preserved verbatim as
    ktemata_r5_lid_cover_waveshare_7in.
    cad/r5_lid_cover.scad (rewritten for the TD2)
    * panel 143.4 x 91.46, R5 corners, 14.92 deep (6.42 body + 8.5 M2.5
    standoffs), 122.74 x 72.96 standoff pattern, centred: 45.05 mm either
    side, 43.32 mm above and below.
    * recess 14.92 deep, opening 145.4 x 93.46 (body + 1.0 a side), glass
    flush with the whole front face at z = 18.92 (was 14.50).
    * 4 x DIN 7991 M2.5 x 8 through the 4 mm rear skin into the panel's own
    standoff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
    [assembly_r5.scad, common.scad, export.scad, ktemata_r5_cass.3mf, ktemata_r5_lid_cover.stl, ktemata_r5_lid_cover_test_dimensions.stl, ktemata_r5_lid_cover_waveshare_7in.stl, ktemata_r5_lid_plate.stl]
2026-11-12 Charge-input sense line: one ADC channel on the UPS DC input
    The HAT (B)'s INA219 sits on the pack branch, so pack current alone cannot say whether a source is
    connected (a full pack on a charger reads near zero) or whether it can carry the load. One ADC
    channel now taps the DC input.
    Hardware
    * R1 30k rail -> pin, R2 10k pin -> GND, 100 nF across R2.
    * (R1+R2)/R2 = 4.0, so 8.4 V reads 2.10 V - mid-range for 11 dB, and 12 V would still be 3.0 V.
    * 210 uA from the charger; a dead rail divides to 0 V, so the pack is untouched.
    * A0 / GPIO36 (ADC1_CH0) on the FireBeetle 2; A1/A2/A3 = 39/34/35 alternate, A6 is GPIO4 (button).
    ADC1 only - ADC2 belongs to the radio. -DPIN_CHG_SENSE ov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
2026-11-12 telemetry: source=unknown without a gauge; document the Pi 5 5 A notice
    * sendTelemetry() claimed source="battery" whenever no charge rail was present - including on the
    bench, with the INA219 absent and the board running off its USB lead. "battery" now needs both
    halves of the claim: no rail AND a gauge that says the pack is supplying; otherwise "unknown".
    The OLED is unaffected (it reads the sense line directly), and status-oled.py ignores the field.
    * POWER.md: the Pi 5 warning "not capable of supplying 5 A" is expected here - the HAT feeds 5 V
    onto the header, which no PD handshake can certify, so the firmware limits USB peripherals to
    600 mA. It is a capability notice, not sag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
    [main.cpp]
2026-11-13 telemetry: source=external when the gauge sees no discharge; log the UI timings
    * source precedence: with no charge-rail sense line (or a floating one, which is what an unfitted
    30k/10k divider reads as) the field fell through to "battery" even while the pack was charging -
    the first real telemetry showed mains:true, charging:true and source:"battery" side by side.
    A gauge that reports no discharge now proves "external"; "battery" still needs a discharging pack.
    * the mcu boot line carries auto_cycle_ms and screen_off_ms, so a build that lost platformio.ini's
    build flags reports 0 there. That is how "the screens stopped rotating" looks: AUTO_CYCLE_MS 0
    means "stay on the time scree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
2026-11-14 r5 deck: the three ordered panel parts get their cuts
    Parts on the bench: a 16 mm latching metal switch (ABS16CG11ZCB3V), a DC-099 5.5 x 2.1 panel
    jack, and the PBS-33B 12 mm button. Their real dimensions, not the ones the design assumed:
    * 16 mm power button: the existing 16.2 mm bore already takes it (M16x1, 12 mm thread, panel up to
    10 mm), so no cut changes. The part is LATCHING and rated 3 A / 24 V DC, so it cannot switch the
    Pi's 5 V rail (5 A spec, ~2.8 A in this build); documented for the 8.4 V charge lead instead, with
    the LED fed from 5 V. BOM item 23b replaced by the ordered part.
    * charge socket: R5_CHG_D 9.5 -> 11.2. The DC-099 mounts through an 11 mm hole where the r4 so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
    [assembly_r5.scad, common.scad, ktemata_r5_deck.stl, r5_deck.scad]
2026-11-14 BOM: the ordered fuse and holder
    BLX-A 5x20 mm PCB holder (TinyTronics 001195, 5 A / 250 V, hinged cover) and an ESKA 5x20 F
    5 A / 250 V fuse (007152) replace the "fuse + holder, 3-5 A" placeholder.
    Sizing, so the next person does not have to redo it: a full 5 V / 5 A output is about 3.8 A at the
    pack (25 W out / 0.88 / 7.4 V lowest pack voltage), and this build's steady draw is about 2.1 A,
    so the 5 A fuse runs at 40-75 % of rating. Holder and fuse are matched at 5 A, which makes the
    holder the weak link by design; the 6.3 A BLX-A variant is the option if that margin is wanted.
    It goes in the pack's POSITIVE lead, in series before the HAT - not in the 8.4 V charge lead, where
    5 A would pr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
2026-11-14 WIRING.md is r5-only; drop the r3 wiring artefacts
    The page described three builds at once: r2/r3 sections, an r4 delta block and r5 notes, plus two block
    diagrams, a KiCad schematic and a netlist CSV that all drew the HAT (E) + 4S + USB-C-PD build. All of the
    earlier-build content is gone and the r5 facts are kept:
    * power: one 8.4 V input through the DC-099 in the deck, 2S pack with the 5 A BLX-A fuse, the 16 mm switch
    (3 A, so the charge lead not the Pi rail), the soldered 5 V / GND pair to the Pi, USB-A 5 V to the
    FireBeetle, ML-2020 on J5;
    * data: Touch Display 2 over the 22->15-pin FFC plus its 3-pin J1 power cable (auto-detected), the 7" cover
    as an explicitly labelled alternat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
    [ktemata_r3_connections.csv, ktemata_r3_wiring.kicad_sch]
2026-11-14 BOM: future main-rail switch or MOSFET/relay in nice-to-have
2026-11-14 Drop r1-r4 from the CAD: one build, no switches
    The repo modelled five revisions behind two flags in cad/common.scad (R4, R2) plus an R5 mode, with
    pick(r4, r2r3, r1) on almost every dimension, four part files for the printed exterior, a corner
    overmould tool and a per-variant export/render pipeline. None of that is wanted any more: r5 is the
    build and there is no scenario in which an earlier release would be printed.
    CAD
    * cad/common.scad: 945 -> 672 lines, one parameter set. The 145 dimensions that only r1-r4 used are
    gone, every pick(a, b, c) reduced to its r4 value, and the switch declarations, the pick()
    function and the `assert(R5, ...)` guards removed. The remaining r5 code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
    [assembly.scad, assembly_r5.scad, bottom.scad, charge_plug.scad, common.scad, corner_mould.scad, corner_mould_check.scad, export.scad]
